CarlosVieira99/3D-Indoor-Mapping/Mechanical Structure/images/1dfa32b80d10521eedfa75d592b94568_preview_featured.jpg

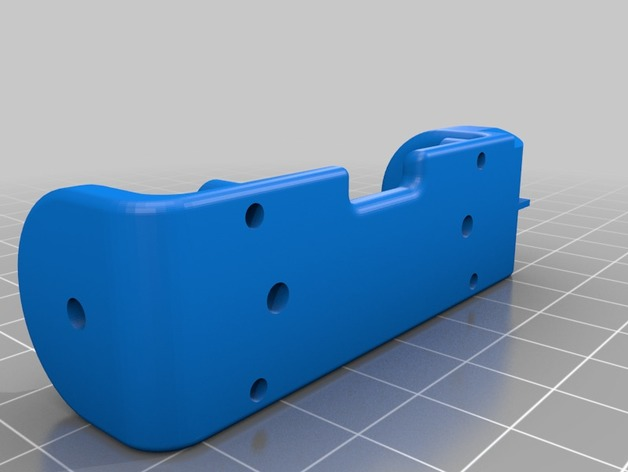
Mechanical Structure/images/1dfa32b80d10521eedfa75d592b94568_preview_featured.jpg
