CarlosVieira99/3D-Indoor-Mapping/Mechanical Structure/images/387c944284d6165e7ca117022d36e841_preview_featured.jpg

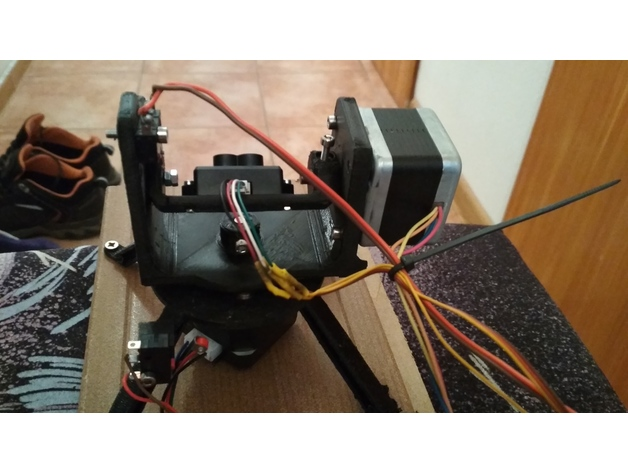
Mechanical Structure/images/387c944284d6165e7ca117022d36e841_preview_featured.jpg
