CarlosVieira99/3D-Indoor-Mapping/README.md

# 3D-Indoor-Mapping
Final year's bachelor project and report with a final classification of 19 (scale of 0 - 20). Development of a 3D Scanner for indoor spaces with applications related to architecture and civil engineering.
