CarlosVieira99/3D-Indoor-Mapping/BNO055/ACC_X.png

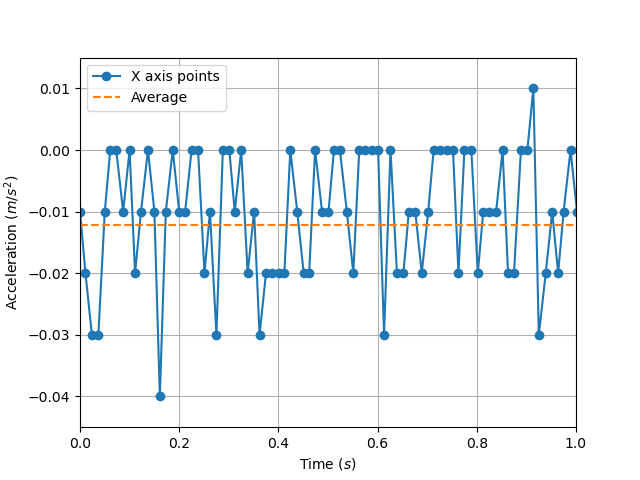
BNO055/ACC_X.png
