CarlosVieira99/3D-Indoor-Mapping/BNO055/ACC_Y.png

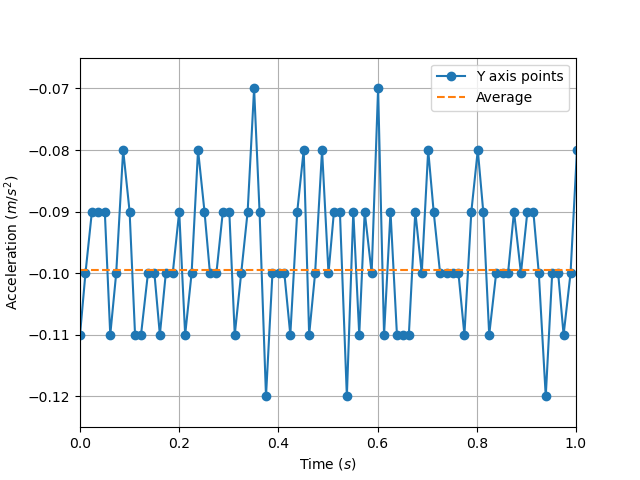
BNO055/ACC_Y.png
