CarlosVieira99/3D-Indoor-Mapping/BNO055/ACC_Z.png

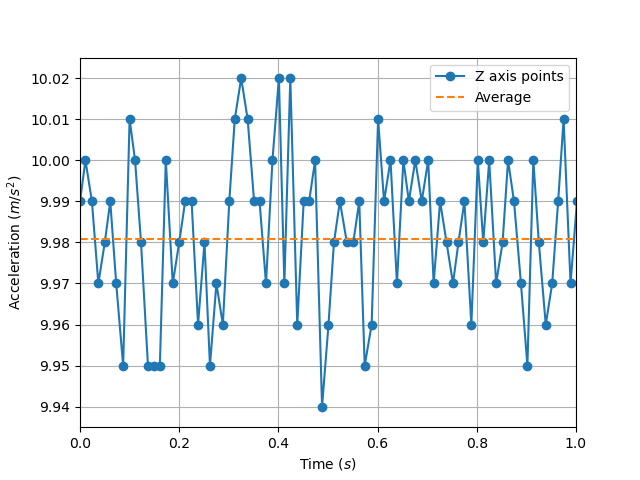
BNO055/ACC_Z.png
