CarlosVieira99/3D-Indoor-Mapping/BNO055/GYR_X.png

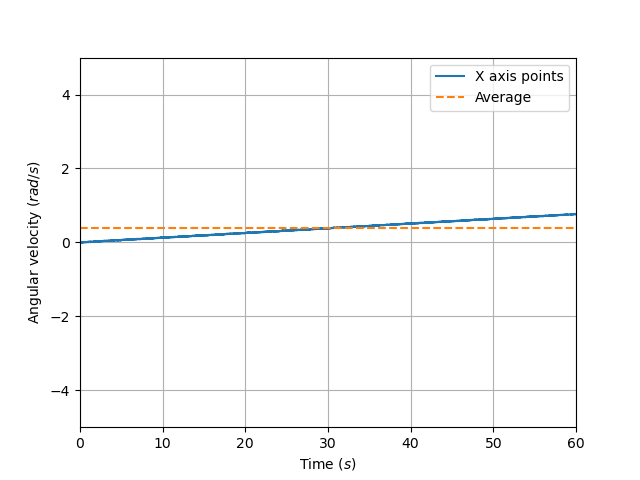
BNO055/GYR_X.png
