CarlosVieira99/3D-Indoor-Mapping/BNO055/GYR_Y.png

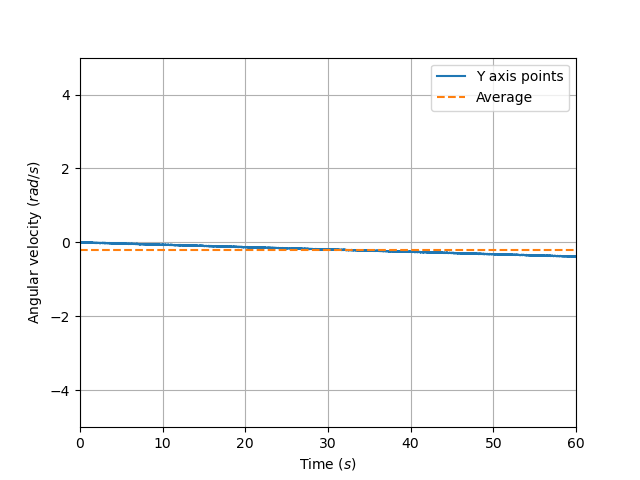
BNO055/GYR_Y.png
