CarlosVieira99/3D-Indoor-Mapping/BNO055/MAG_X.png

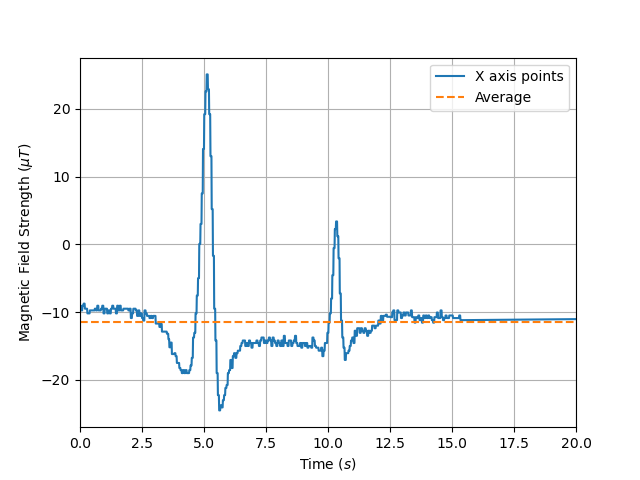
BNO055/MAG_X.png
