CarlosVieira99/3D-Indoor-Mapping/BNO055/MAG_Y.png

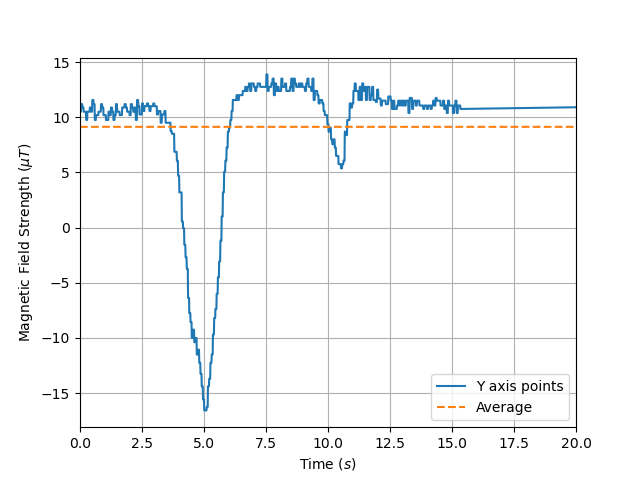
BNO055/MAG_Y.png
