CarlosVieira99/3D-Indoor-Mapping/BNO055/MAG_Z.png

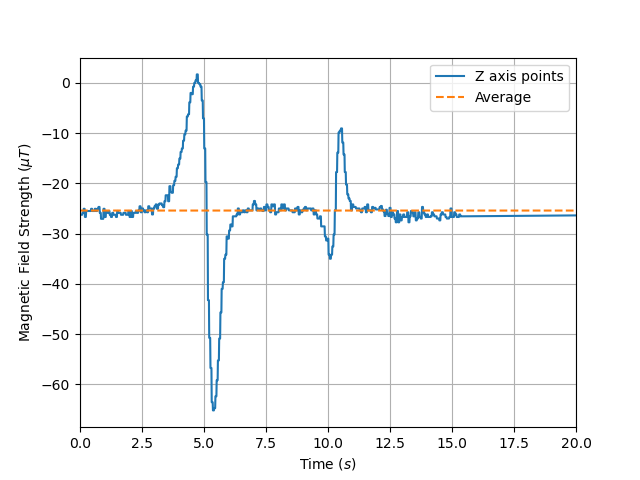
BNO055/MAG_Z.png
