CarlosVieira99/3D-Indoor-Mapping/BNO055/PITCH.png

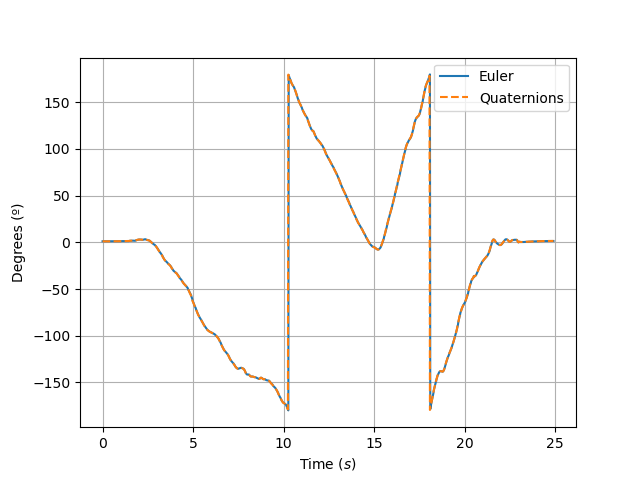
BNO055/PITCH.png
