CarlosVieira99/3D-Indoor-Mapping/BNO055/ROLL.png

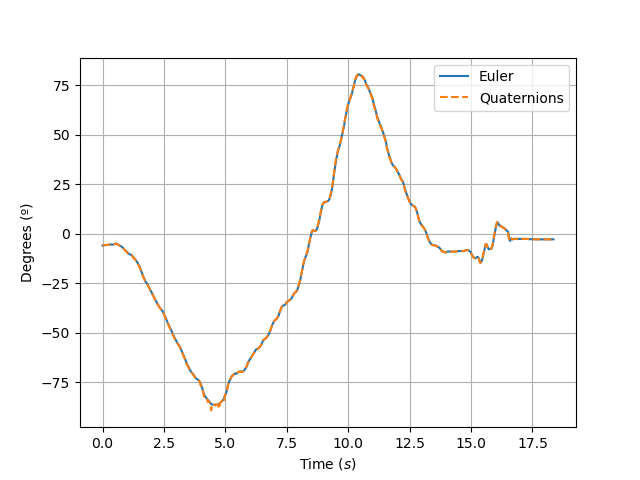
BNO055/ROLL.png
