CarlosVieira99/3D-Indoor-Mapping/BNO055/YAW.png

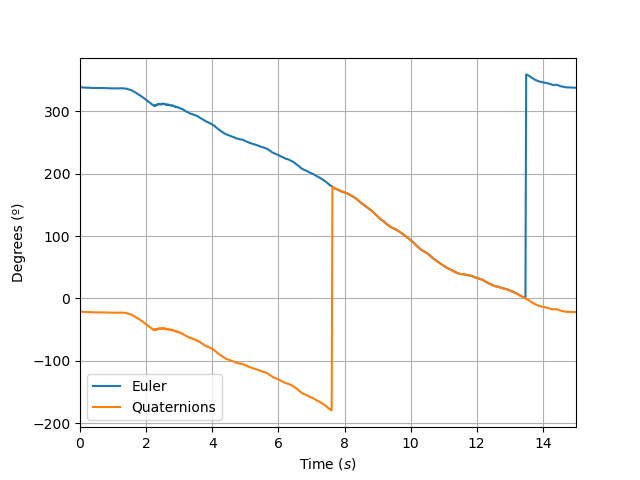
BNO055/YAW.png
