CarlosVieira99/3D-Indoor-Mapping/Mechanical Structure/case_pcb.png

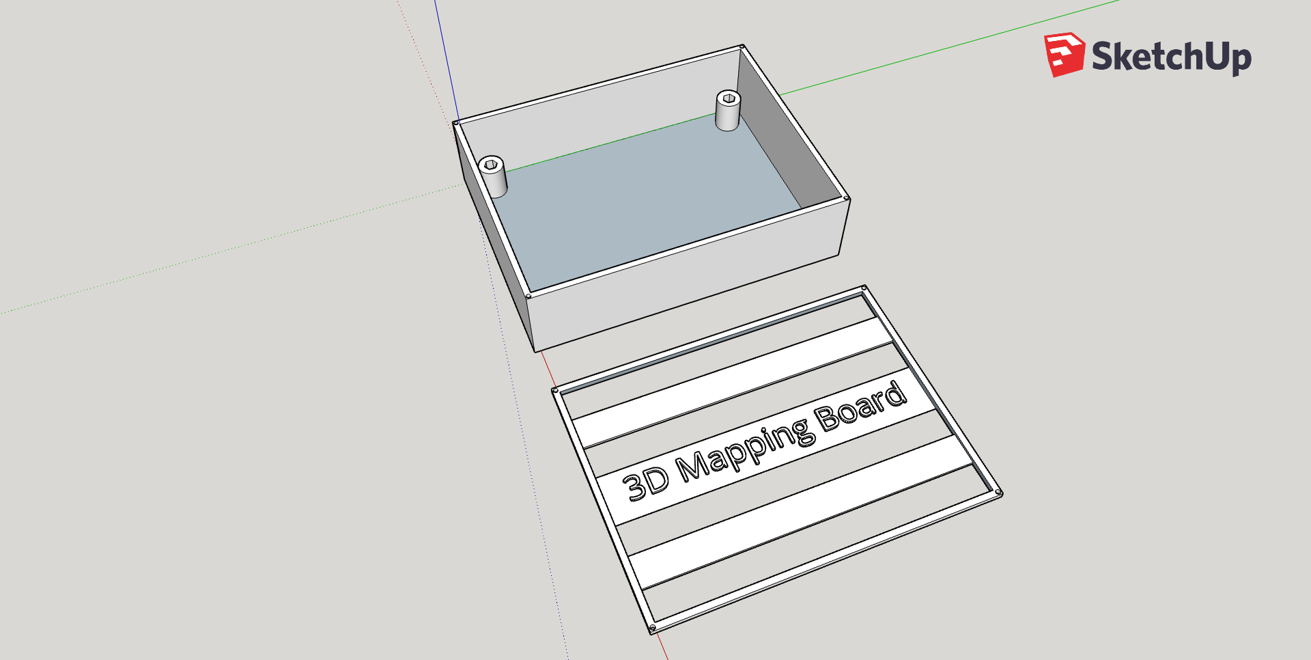
Mechanical Structure/case_pcb.png
