CarlosVieira99/3D-Indoor-Mapping/Mechanical Structure/images/2bb4d0dabb0714f8ff6427e0e310aa0e_preview_featured.jpg

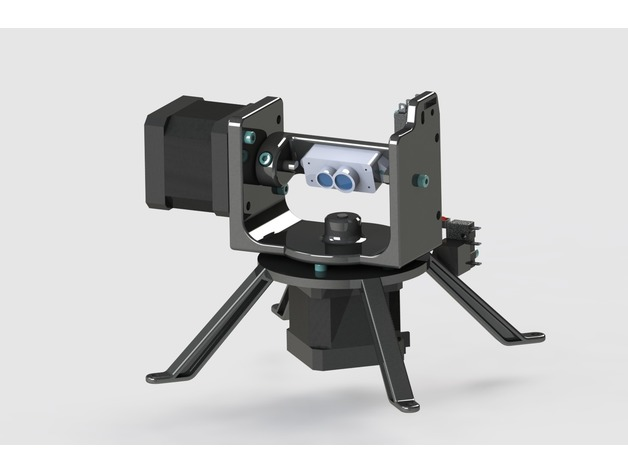
Mechanical Structure/images/2bb4d0dabb0714f8ff6427e0e310aa0e_preview_featured.jpg
