CarlosVieira99/3D-Indoor-Mapping/Mechanical Structure/images/4da6ced4066a0352c191759d1605e79c_preview_featured.jpg

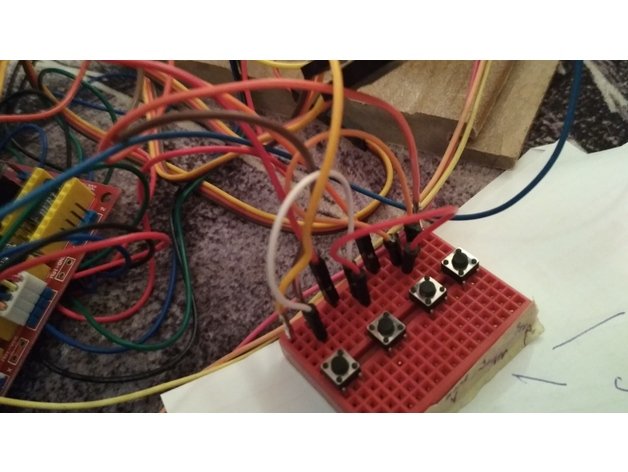
Mechanical Structure/images/4da6ced4066a0352c191759d1605e79c_preview_featured.jpg
