CarlosVieira99/3D-Indoor-Mapping/Mechanical Structure/images/55c08e975283f3232b39a6d8d862f61d_preview_featured.jpg

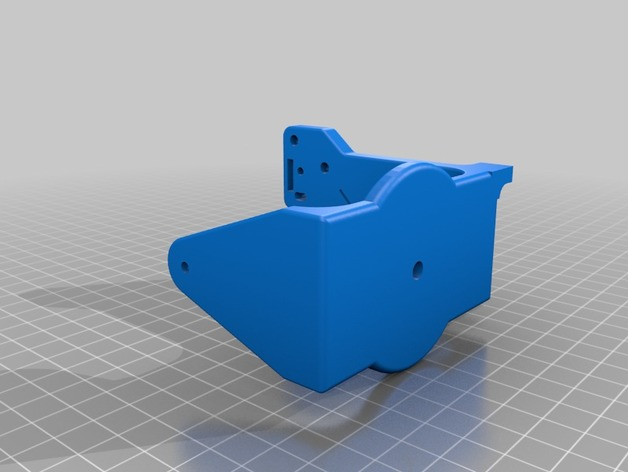
Mechanical Structure/images/55c08e975283f3232b39a6d8d862f61d_preview_featured.jpg
