CarlosVieira99/3D-Indoor-Mapping/Mechanical Structure/images/73e55405f893b6189121a46dec58b1c0_preview_featured.jpg

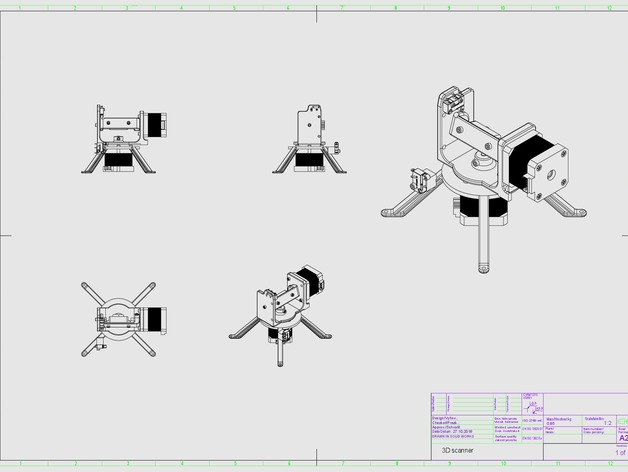
Mechanical Structure/images/73e55405f893b6189121a46dec58b1c0_preview_featured.jpg
