CarlosVieira99/3D-Indoor-Mapping/Mechanical Structure/images/177eeb8ad4d8bed2c6603e06b150ce1c_preview_featured.jpg

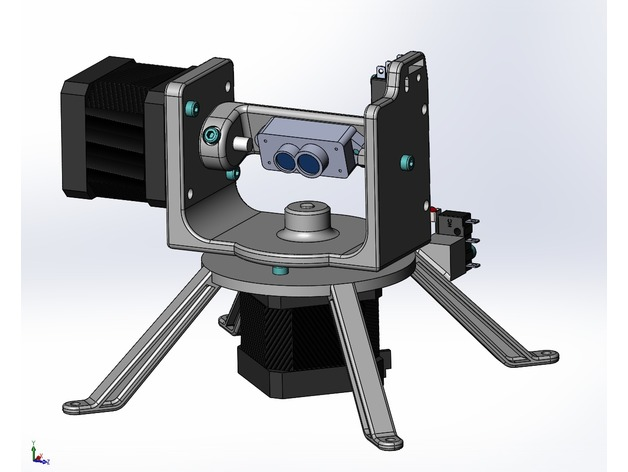
Mechanical Structure/images/177eeb8ad4d8bed2c6603e06b150ce1c_preview_featured.jpg
