CarlosVieira99/3D-Indoor-Mapping/Mechanical Structure/images/0367f8c9bfd212b43cd1ec062f2c5a4a_preview_featured.jpg

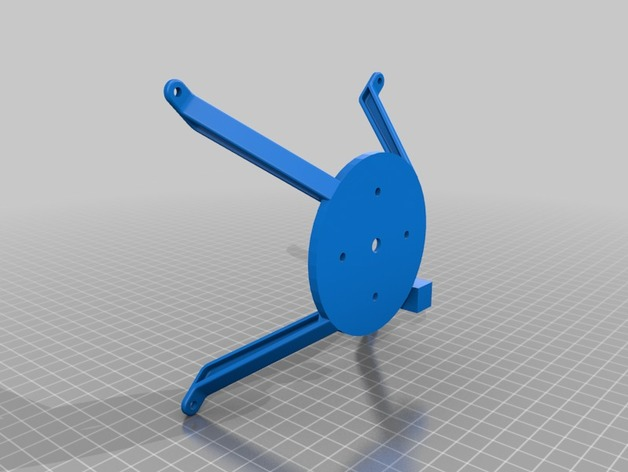
Mechanical Structure/images/0367f8c9bfd212b43cd1ec062f2c5a4a_preview_featured.jpg
