CarlosVieira99/3D-Indoor-Mapping/Mechanical Structure/images/50722d846d7203ce73d94f9868e5be8e_preview_featured.JPG

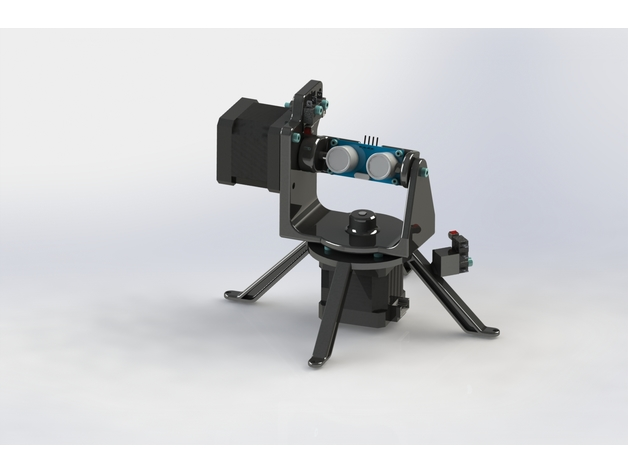
Mechanical Structure/images/50722d846d7203ce73d94f9868e5be8e_preview_featured.JPG
