CarlosVieira99/3D-Indoor-Mapping/Mechanical Structure/images/b529cb4edfc250e49e4f99960e645187_preview_featured.jpg

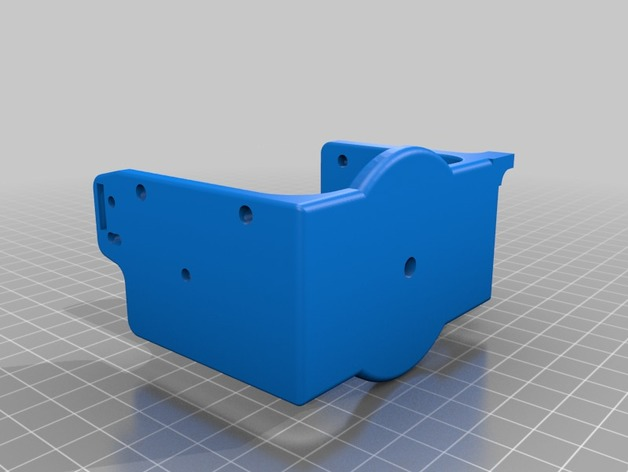
Mechanical Structure/images/b529cb4edfc250e49e4f99960e645187_preview_featured.jpg
