CarlosVieira99/3D-Indoor-Mapping/Mechanical Structure/images/b7080d9011f67d9f4980e71822f7f7c1_preview_featured.jpg

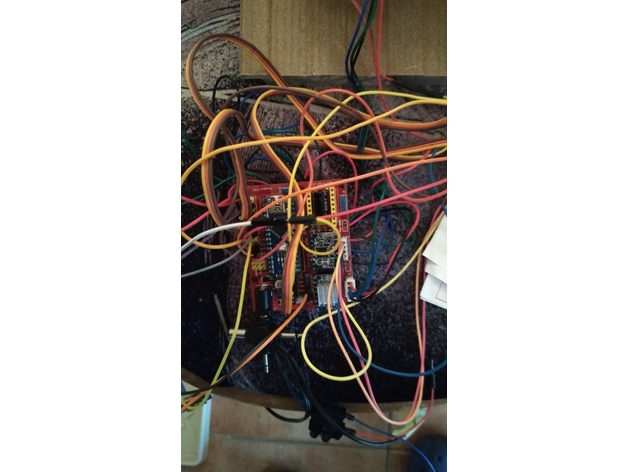
Mechanical Structure/images/b7080d9011f67d9f4980e71822f7f7c1_preview_featured.jpg
