CarlosVieira99/3D-Indoor-Mapping/Mechanical Structure/images/eead3b37182fbacccb547434da534182_preview_featured.jpg

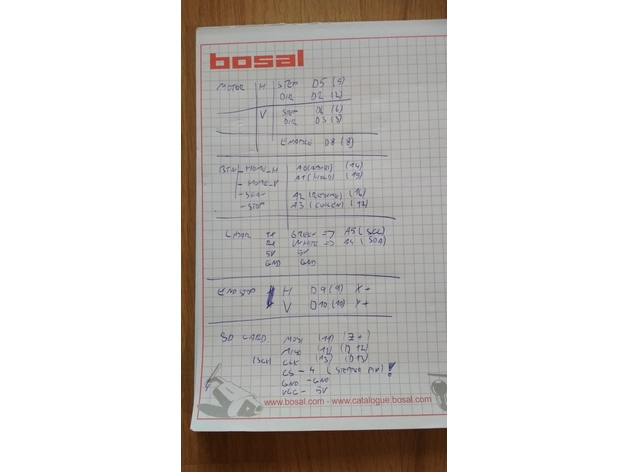
Mechanical Structure/images/eead3b37182fbacccb547434da534182_preview_featured.jpg
