CarlosVieira99/3D-Indoor-Mapping/PCB and Base Design/acricilico v2.png

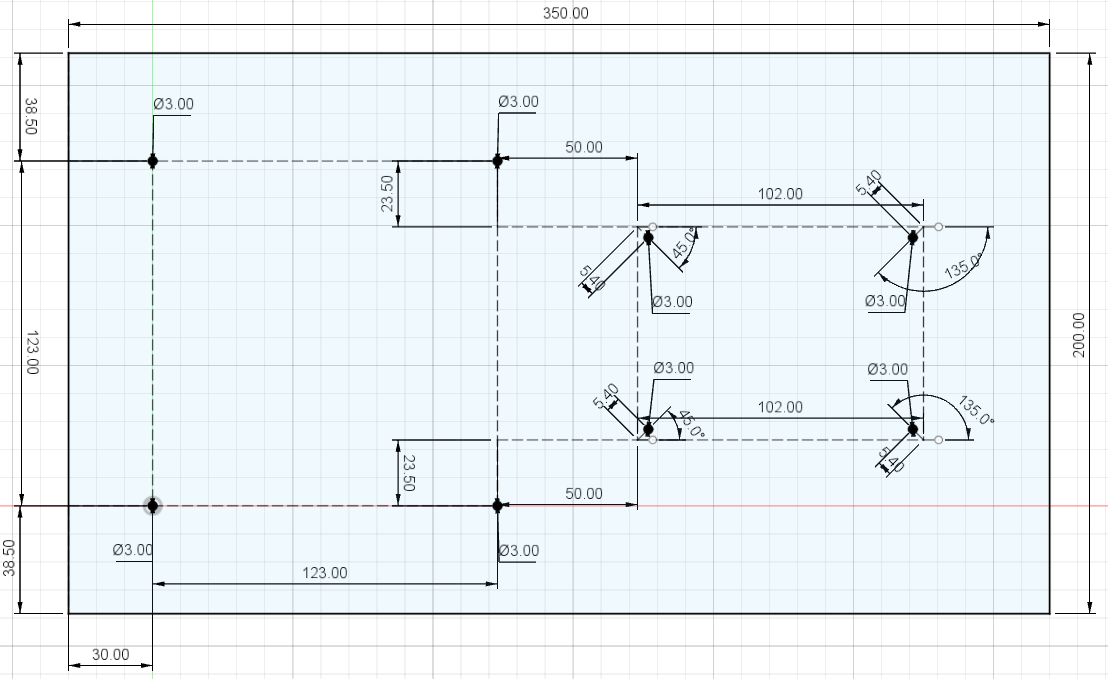
PCB and Base Design/acricilico v2.png
