CarlosVieira99/3D-Indoor-Mapping/User Interface/img/DEE.jpg

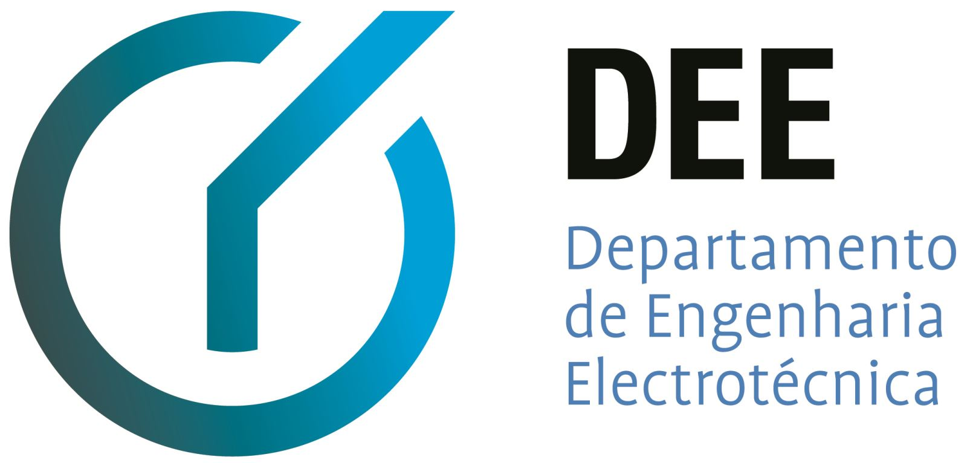
User Interface/img/DEE.jpg
