CarlosVieira99/3D-Indoor-Mapping/User Interface/img/isep.jpeg

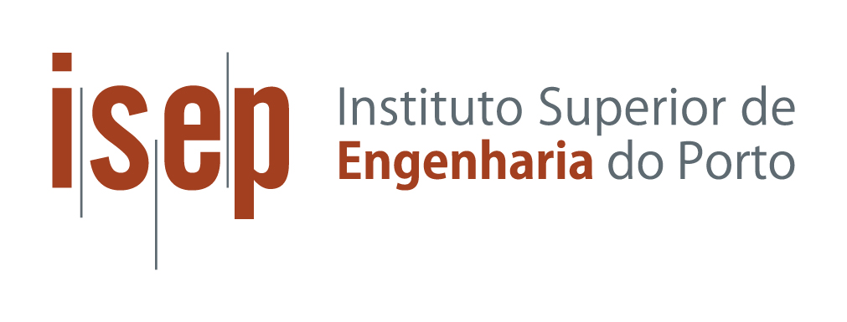
User Interface/img/isep.jpeg
