CarlosVieira99/3D-Indoor-Mapping/Mechanical Structure/files/console2v2.STL

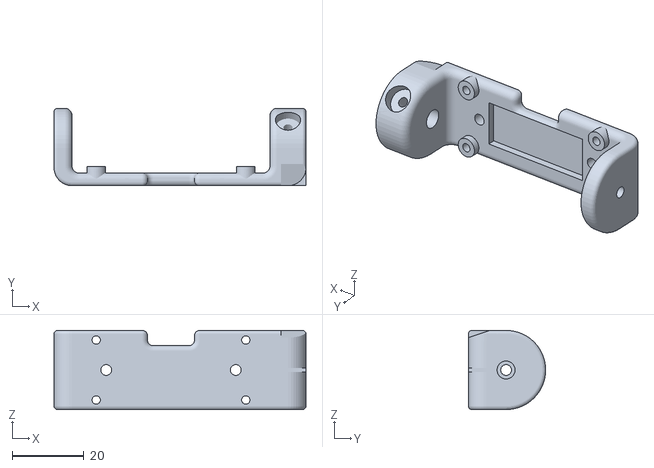
[picture p120: CAD file, 2021-06-29]
Mechanical Structure/files/console2v2.STL
70.0 x 21.5 x 22.0
