CarlosVieira99/3D-Indoor-Mapping/Mechanical Structure/files/console2.STL

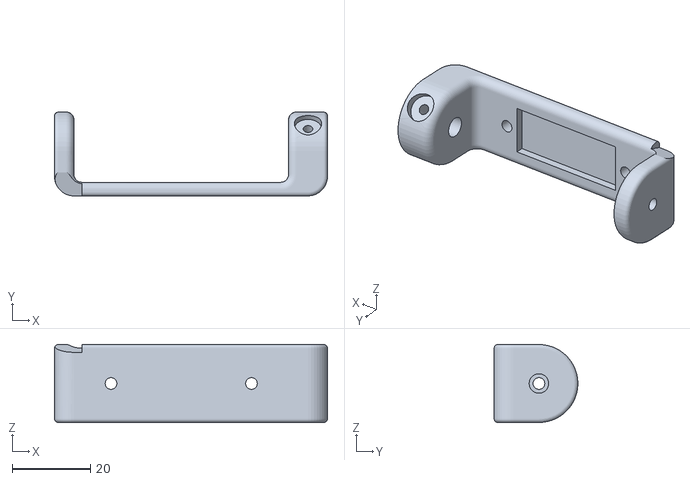
[picture p121: CAD file, 2021-06-29]
Mechanical Structure/files/console2.STL
70.0 x 21.5 x 20.0
