CarlosVieira99/3D-Indoor-Mapping/Mechanical Structure/files/Console1.STL

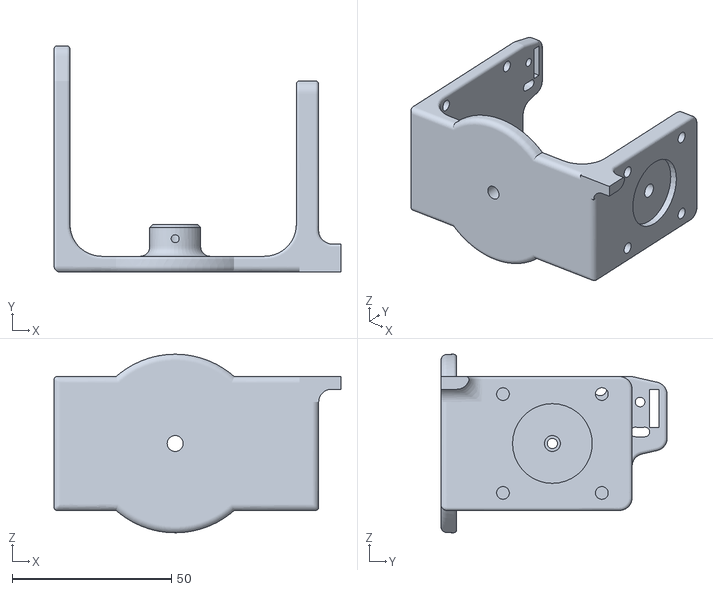
[picture p122: CAD file, 2021-06-29]
Mechanical Structure/files/Console1.STL
90.0 x 71.0 x 56.0
