CarlosVieira99/3D-Indoor-Mapping/Mechanical Structure/files/stand.STL

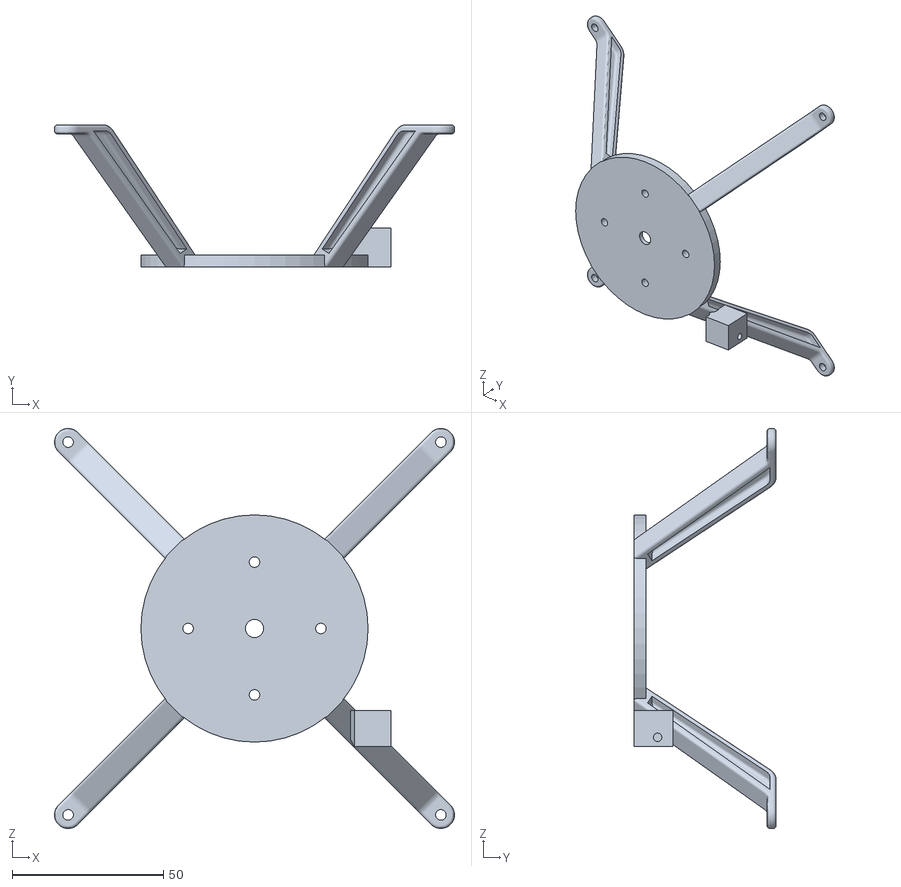
[picture p123: CAD file, 2021-06-29]
Mechanical Structure/files/stand.STL
132.0 x 47.0 x 132.0
