CarlosVieira99/3D-Indoor-Mapping/Mechanical Structure/files/Console1v2.STL

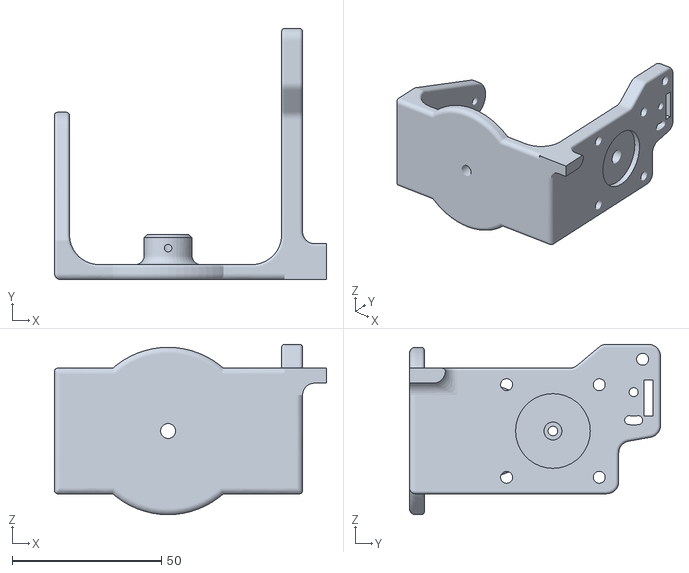
[picture p124: CAD file, 2021-06-29]
Mechanical Structure/files/Console1v2.STL
91.0 x 84.0 x 57.0
