CarlosVieira99/3D-Indoor-Mapping/(list of files, cad)

Other CAD files:
Point Clouds Results/Full Step Mode/FullAutoCadPoints.dwg
PCB and Base Design/acricilico v2.dwg
Point Clouds Results/Half Step Mode/xyz_file.dxf
Point Clouds Results/Quarter Step Mode/xyz_file.dxf
