CarlosVieira99/3D-Indoor-Mapping/Point Clouds Results/Full Step Mode/BluePrintFull.png

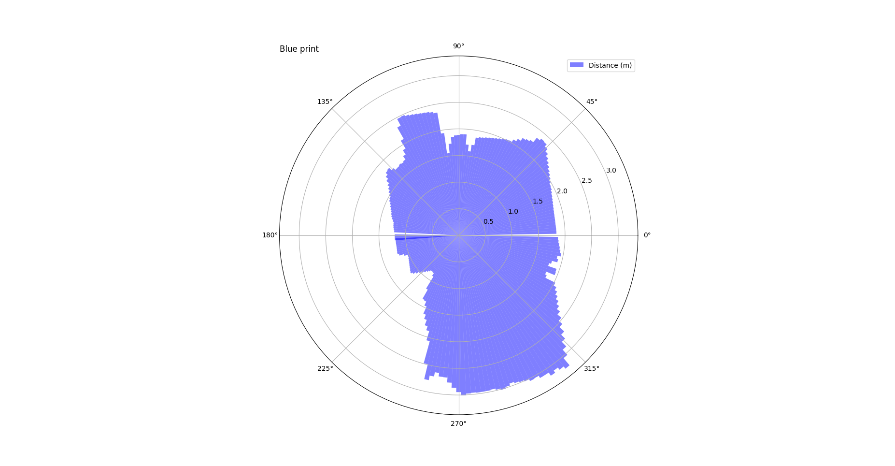
Point Clouds Results/Full Step Mode/BluePrintFull.png
