CarlosVieira99/3D-Indoor-Mapping/Point Clouds Results/Full Step Mode/Figure_1.png

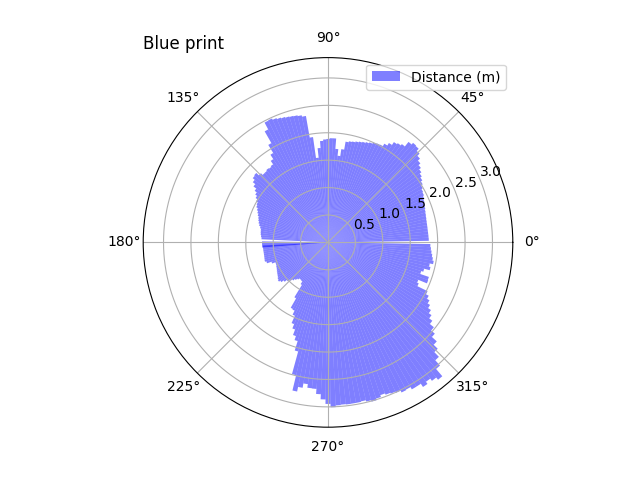
Point Clouds Results/Full Step Mode/Figure_1.png
