CarlosVieira99/3D-Indoor-Mapping/Point Clouds Results/Full Step Mode/FullBlack.png

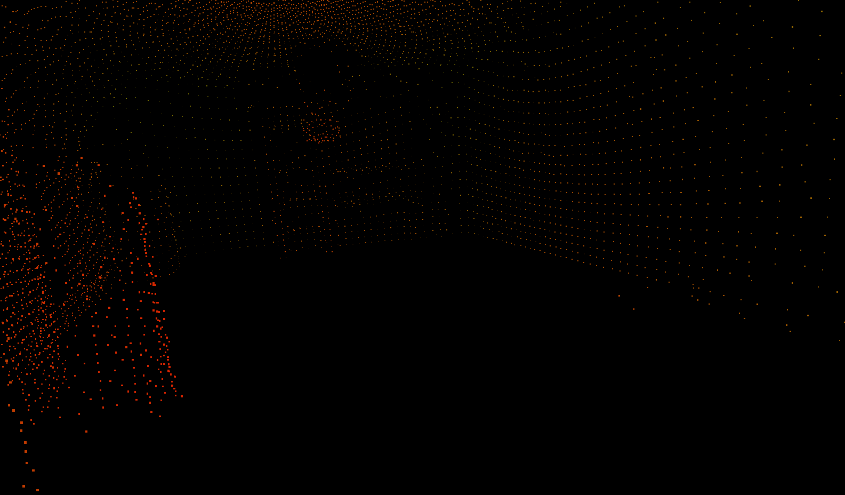
Point Clouds Results/Full Step Mode/FullBlack.png
