CarlosVieira99/3D-Indoor-Mapping/Point Clouds Results/Full Step Mode/FullBlackOut.png

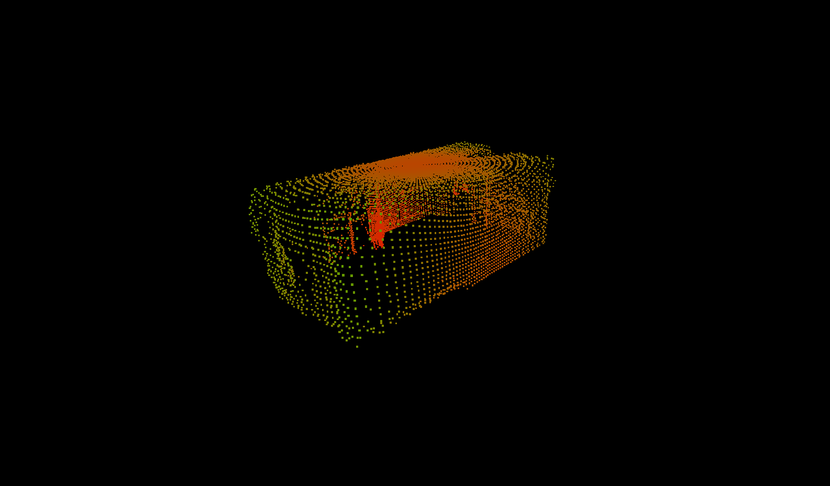
Point Clouds Results/Full Step Mode/FullBlackOut.png
