CarlosVieira99/3D-Indoor-Mapping/Point Clouds Results/Full Step Mode/FullBlackTop.png

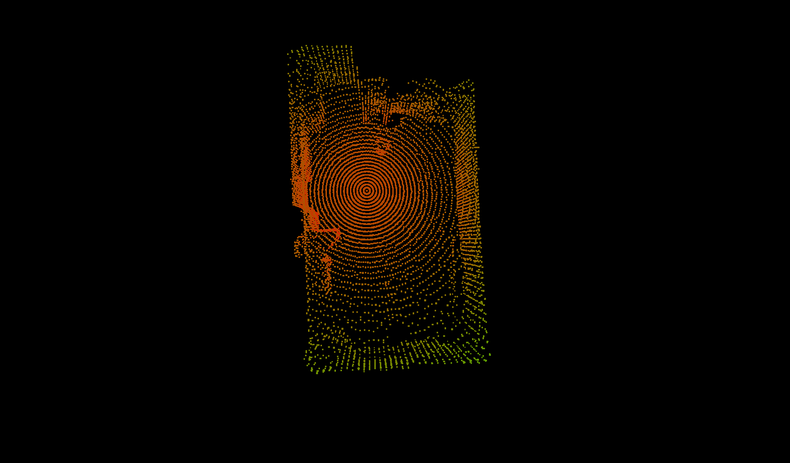
Point Clouds Results/Full Step Mode/FullBlackTop.png
