CarlosVieira99/3D-Indoor-Mapping/Point Clouds Results/Full Step Mode/FullWhite.png

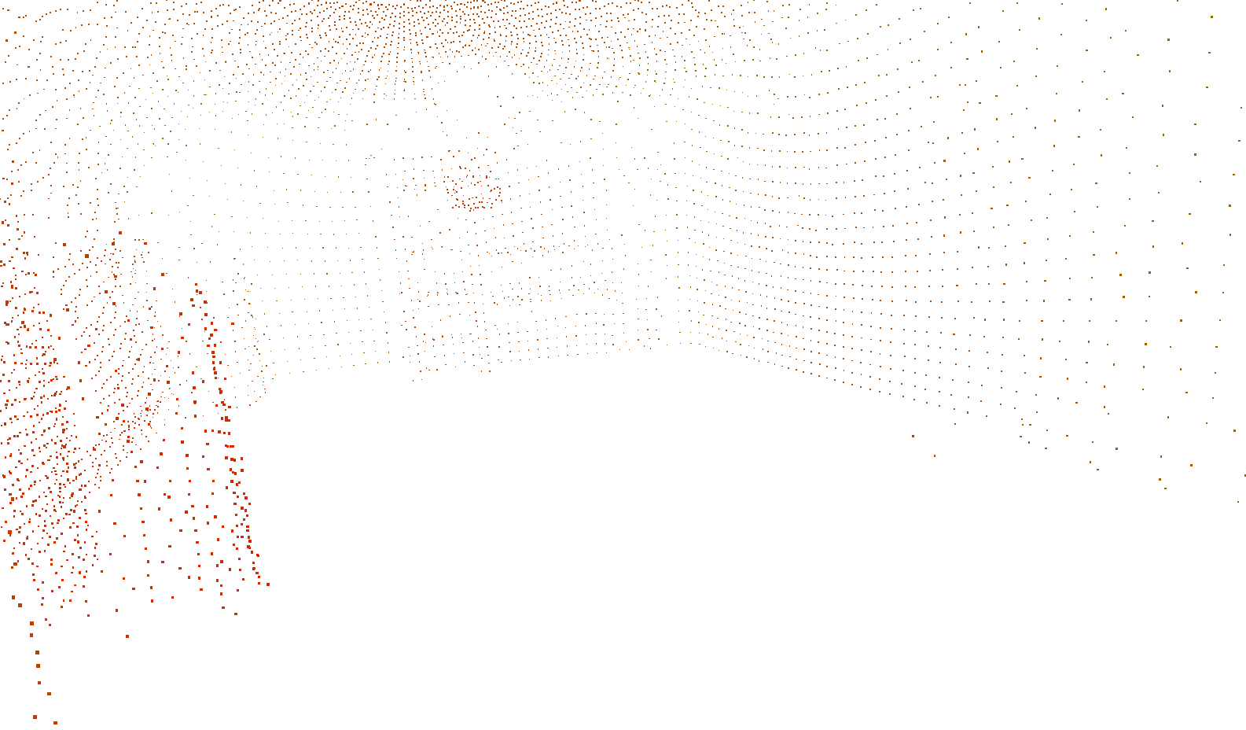
Point Clouds Results/Full Step Mode/FullWhite.png
