CarlosVieira99/3D-Indoor-Mapping/Point Clouds Results/Full Step Mode/FullWhiteOut.png

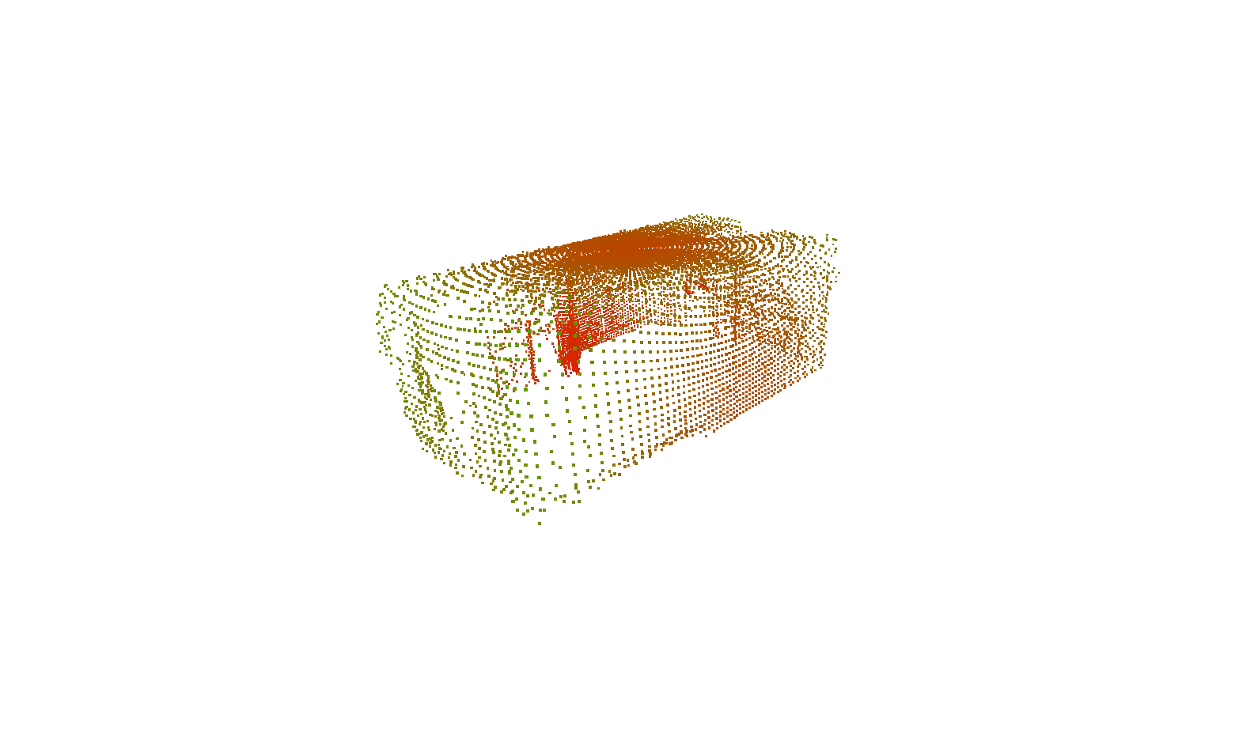
Point Clouds Results/Full Step Mode/FullWhiteOut.png
