CarlosVieira99/3D-Indoor-Mapping/Point Clouds Results/Full Step Mode/FullWhiteTop.png

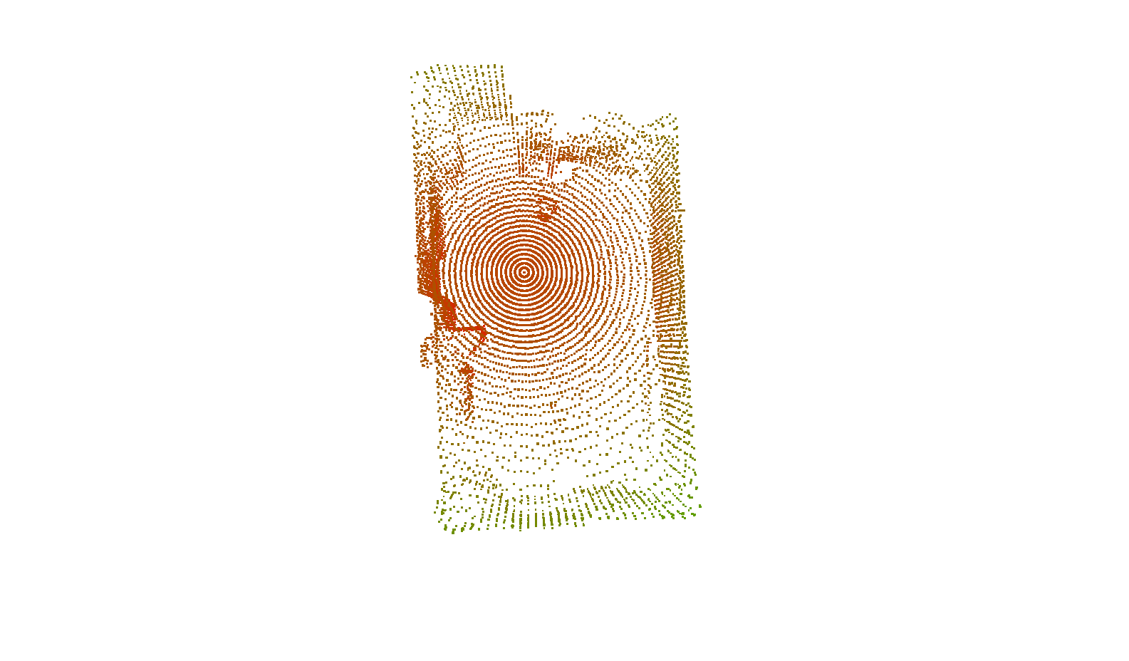
Point Clouds Results/Full Step Mode/FullWhiteTop.png
