CarlosVieira99/3D-Indoor-Mapping/Point Clouds Results/Half Step Mode/HalfWhite.png

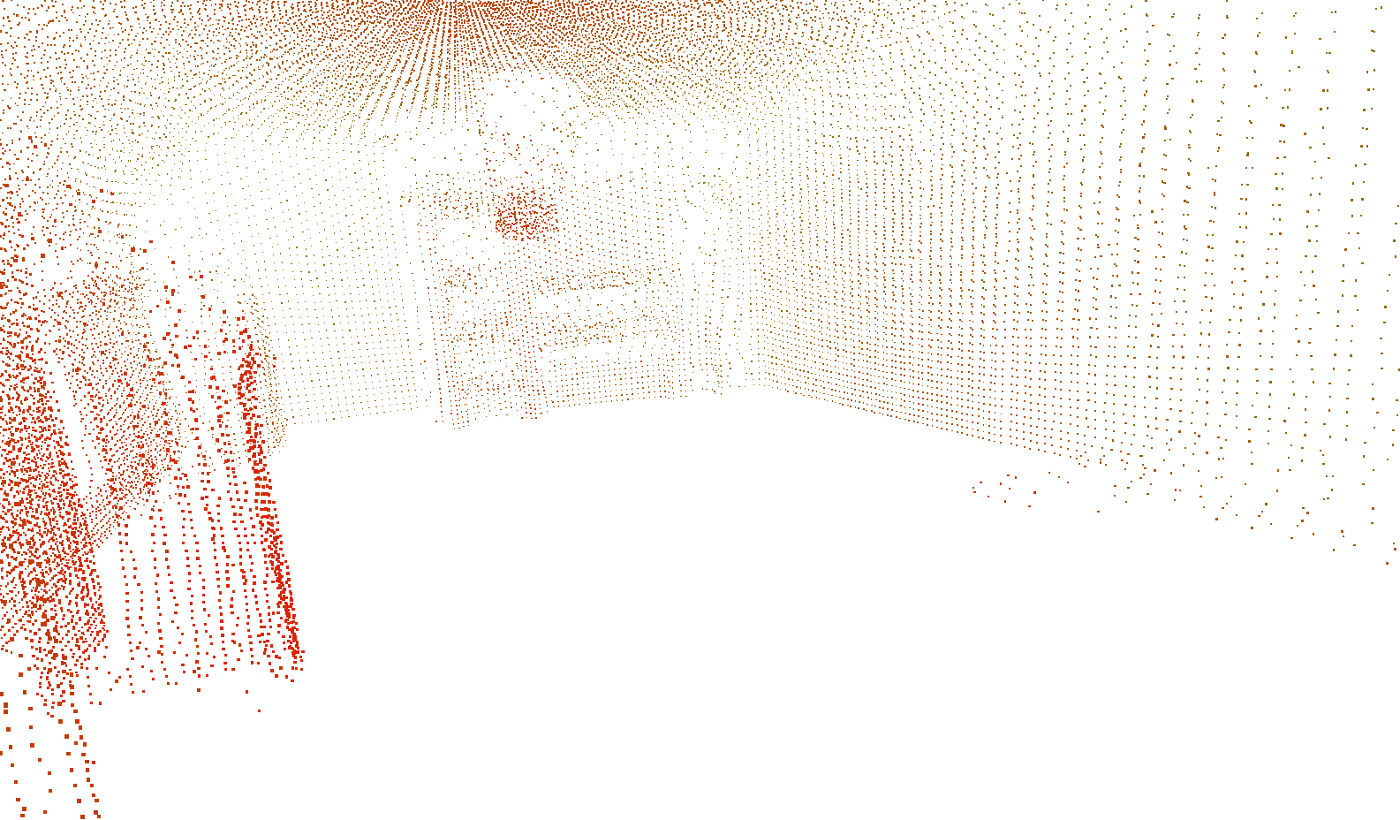
Point Clouds Results/Half Step Mode/HalfWhite.png
