CarlosVieira99/3D-Indoor-Mapping/Point Clouds Results/Half Step Mode/screenshot2.png

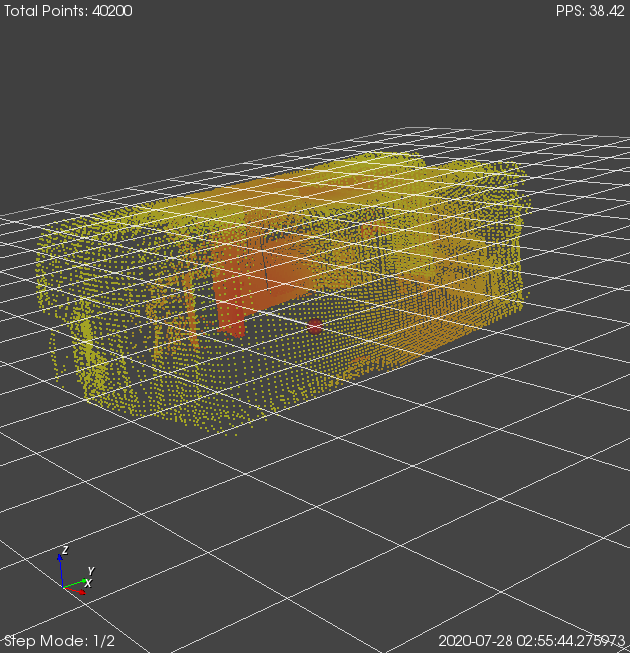
Point Clouds Results/Half Step Mode/screenshot2.png
