CarlosVieira99/3D-Indoor-Mapping/Point Clouds Results/Quarter Step Mode/QuarterBlack.png

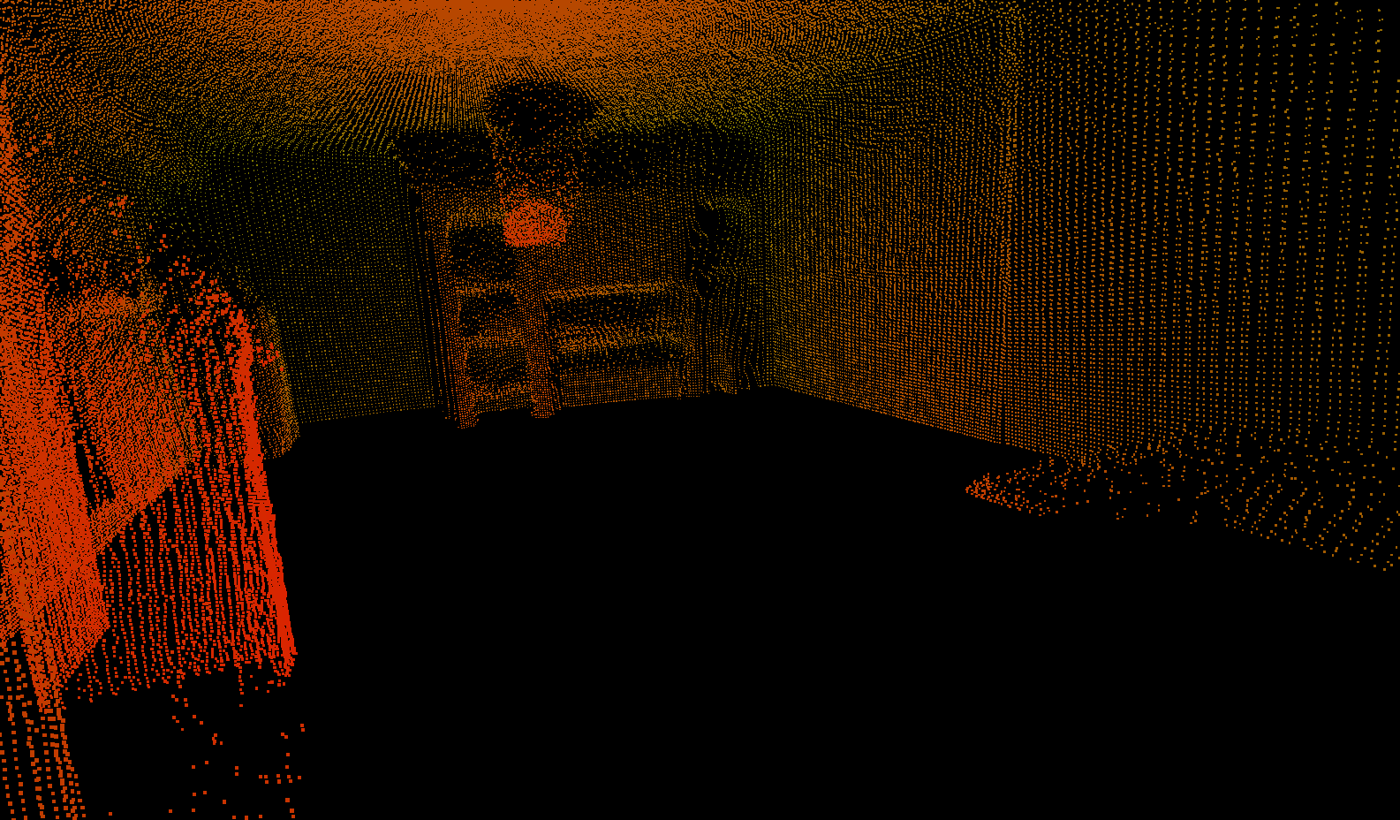
Point Clouds Results/Quarter Step Mode/QuarterBlack.png
