CarlosVieira99/3D-Indoor-Mapping/Point Clouds Results/Quarter Step Mode/QuarterWhite.png

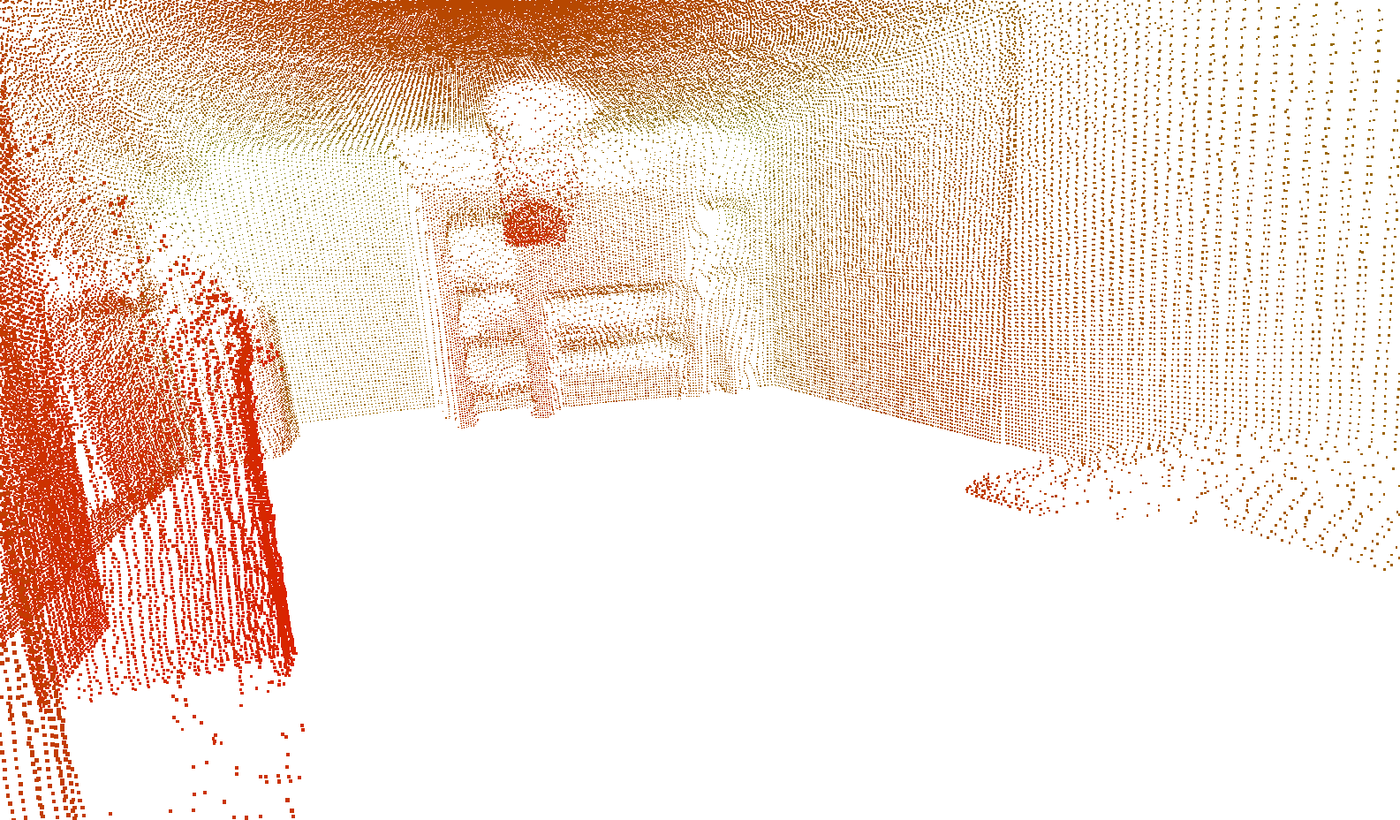
Point Clouds Results/Quarter Step Mode/QuarterWhite.png
