CarlosVieira99/3D-Indoor-Mapping/Point Clouds Results/Quarter Step Mode/QuarterWhiteOut.png

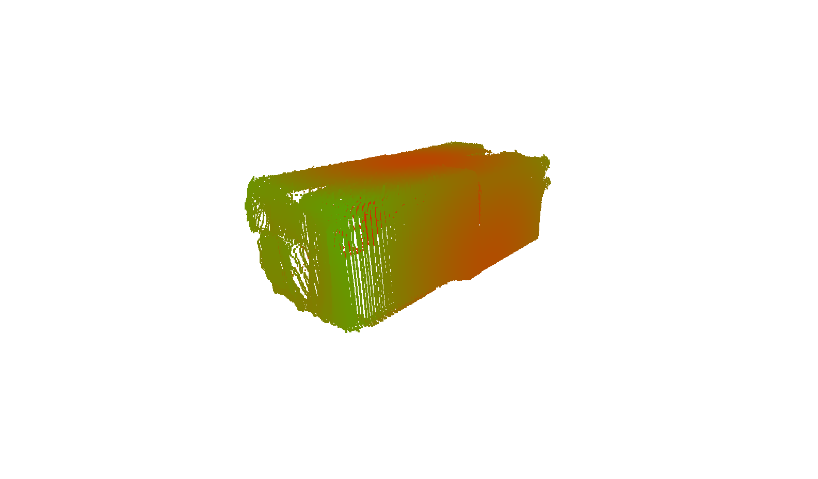
Point Clouds Results/Quarter Step Mode/QuarterWhiteOut.png
