CarlosVieira99/3D-Indoor-Mapping/Point Clouds Results/Quarter Step Mode/screenshot4.png

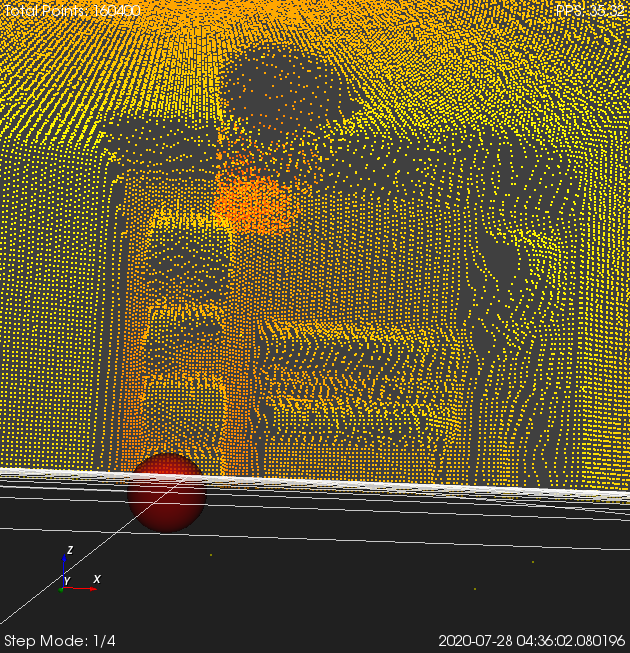
Point Clouds Results/Quarter Step Mode/screenshot4.png
