CarlosVieira99/3D-Indoor-Mapping/TFmini-S/Test1_error.png

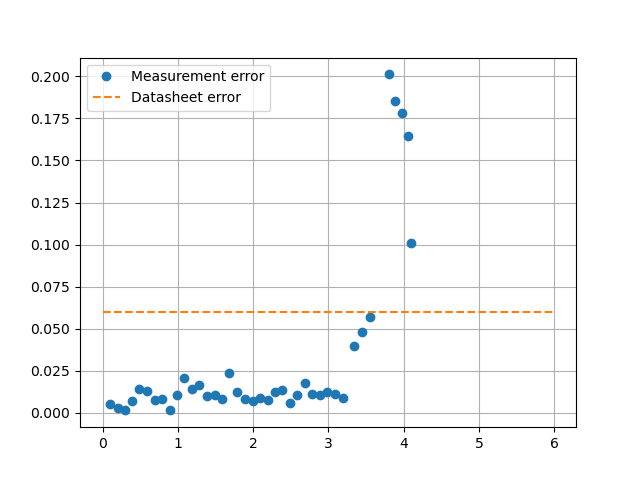
TFmini-S/Test1_error.png
