CarlosVieira99/3D-Indoor-Mapping/TFmini-S/Test2_error.png

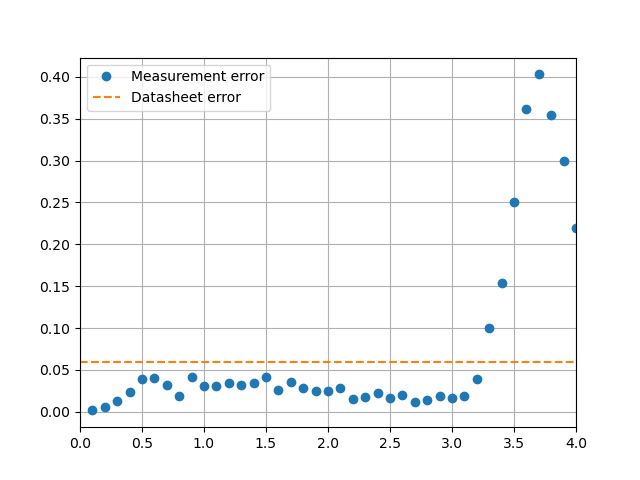
TFmini-S/Test2_error.png
