CarlosVieira99/3D-Indoor-Mapping/TFmini-S/Test3_error.png

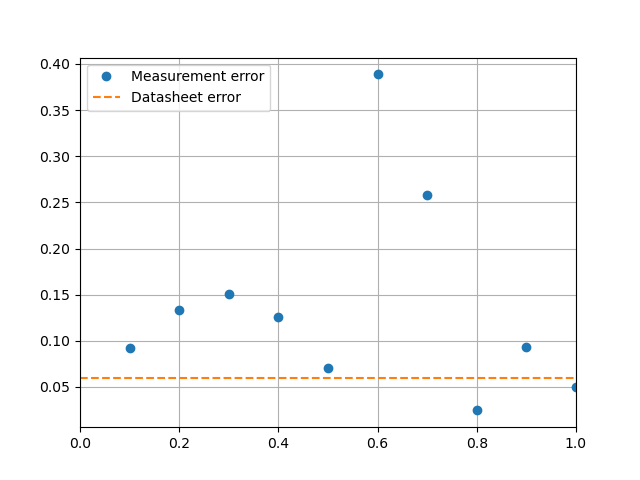
TFmini-S/Test3_error.png
