CarlosVieira99/3D-Indoor-Mapping/TFmini-S/Teste1_dist.png

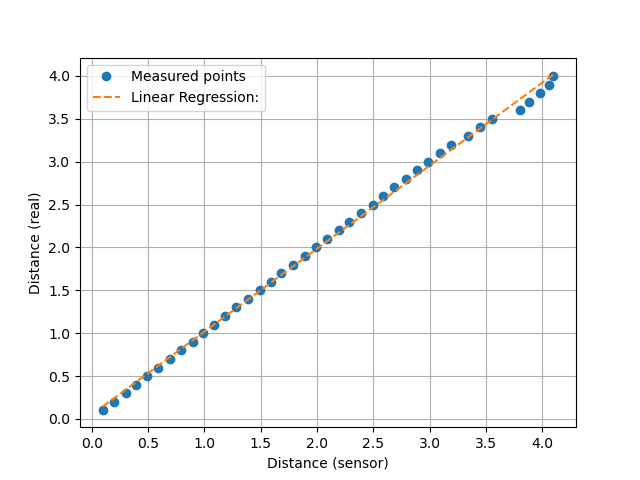
TFmini-S/Teste1_dist.png
