CarlosVieira99/3D-Indoor-Mapping/TFmini-S/Teste2_dist.png

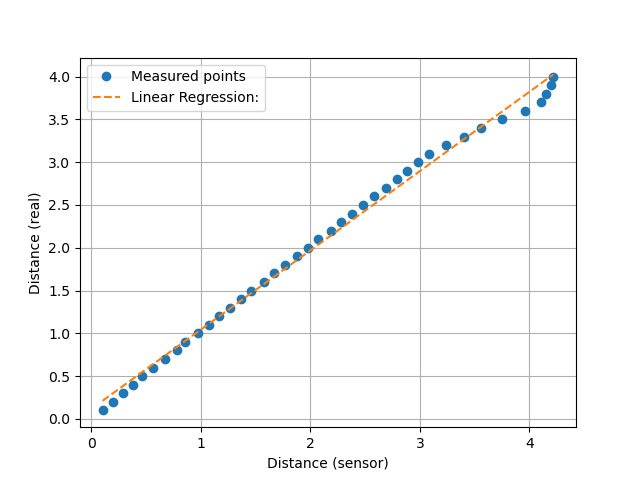
TFmini-S/Teste2_dist.png
