CarlosVieira99/3D-Indoor-Mapping/TFmini-S/Teste3_dist.png

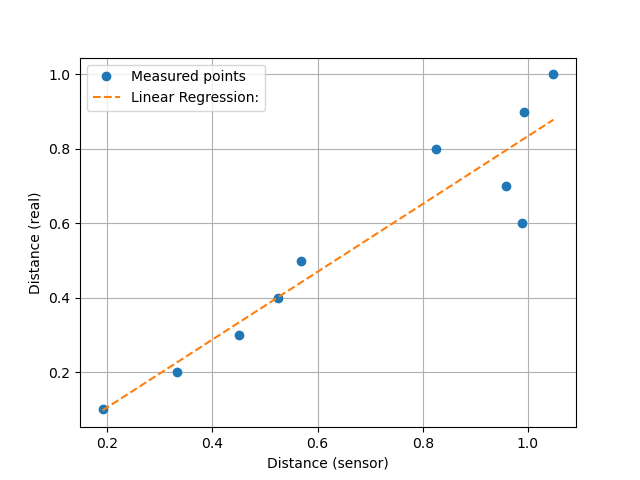
TFmini-S/Teste3_dist.png
