CarlosVieira99/3D-Indoor-Mapping/Architecture.pdf

# 3D Indoor Mapping

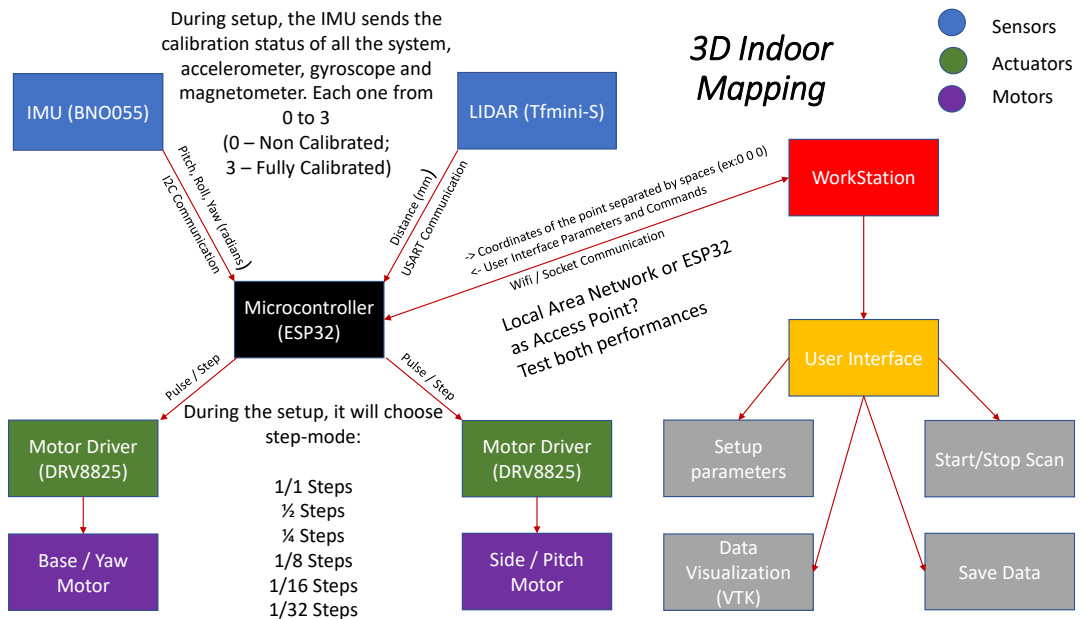
[picture p147: page 1]
Microcontroller (ESP32); Side / Pitch Motor; Base / Yaw Motor; Motor Driver (DRV8825); IMU (BNO055); LIDAR (Tfmini-S); WorkStation; Sensors; Actuators; Motors; User Interface; Setup parameters; Save Data; Data Visualization (VTK); 0 to 3 (0 – Non Calibrated; 3 – Fully Calibrated); step-mode:; 1/1 Steps ½ Steps ¼ Steps 1/8 Steps 1/16 Steps 1/32 Steps

During setup, the IMU sends the
calibration status of all the system,
accelerometer, gyroscope and
magnetometer. Each one from

During the setup, it will choose

Start/Stop Scan

IMU (BNO055)

All sensors available outputs

LIDAR (Tfmini-S)

- Calibration Status (0 to 3)
- Accelerometer (m/s)
- Gyrsoscope (deg/s or rad/s)
- Magnetometer (uTesla)
- Euler Angles (degrees or radians)
- Quaternions (unit quaternion)
- Linear Acceleration (m/s)
- Gravity Vector (m/s^2)
- Temperature (Celsius or Fahrenheit)
- Distance (cm or mm)
- Strength of the signal (0-65535)
- Temperature (Celsius or Fahrenheit)
