CarlosVieira99/3D-Indoor-Mapping/Mechanical Structure/files/3D_scanner.PDF

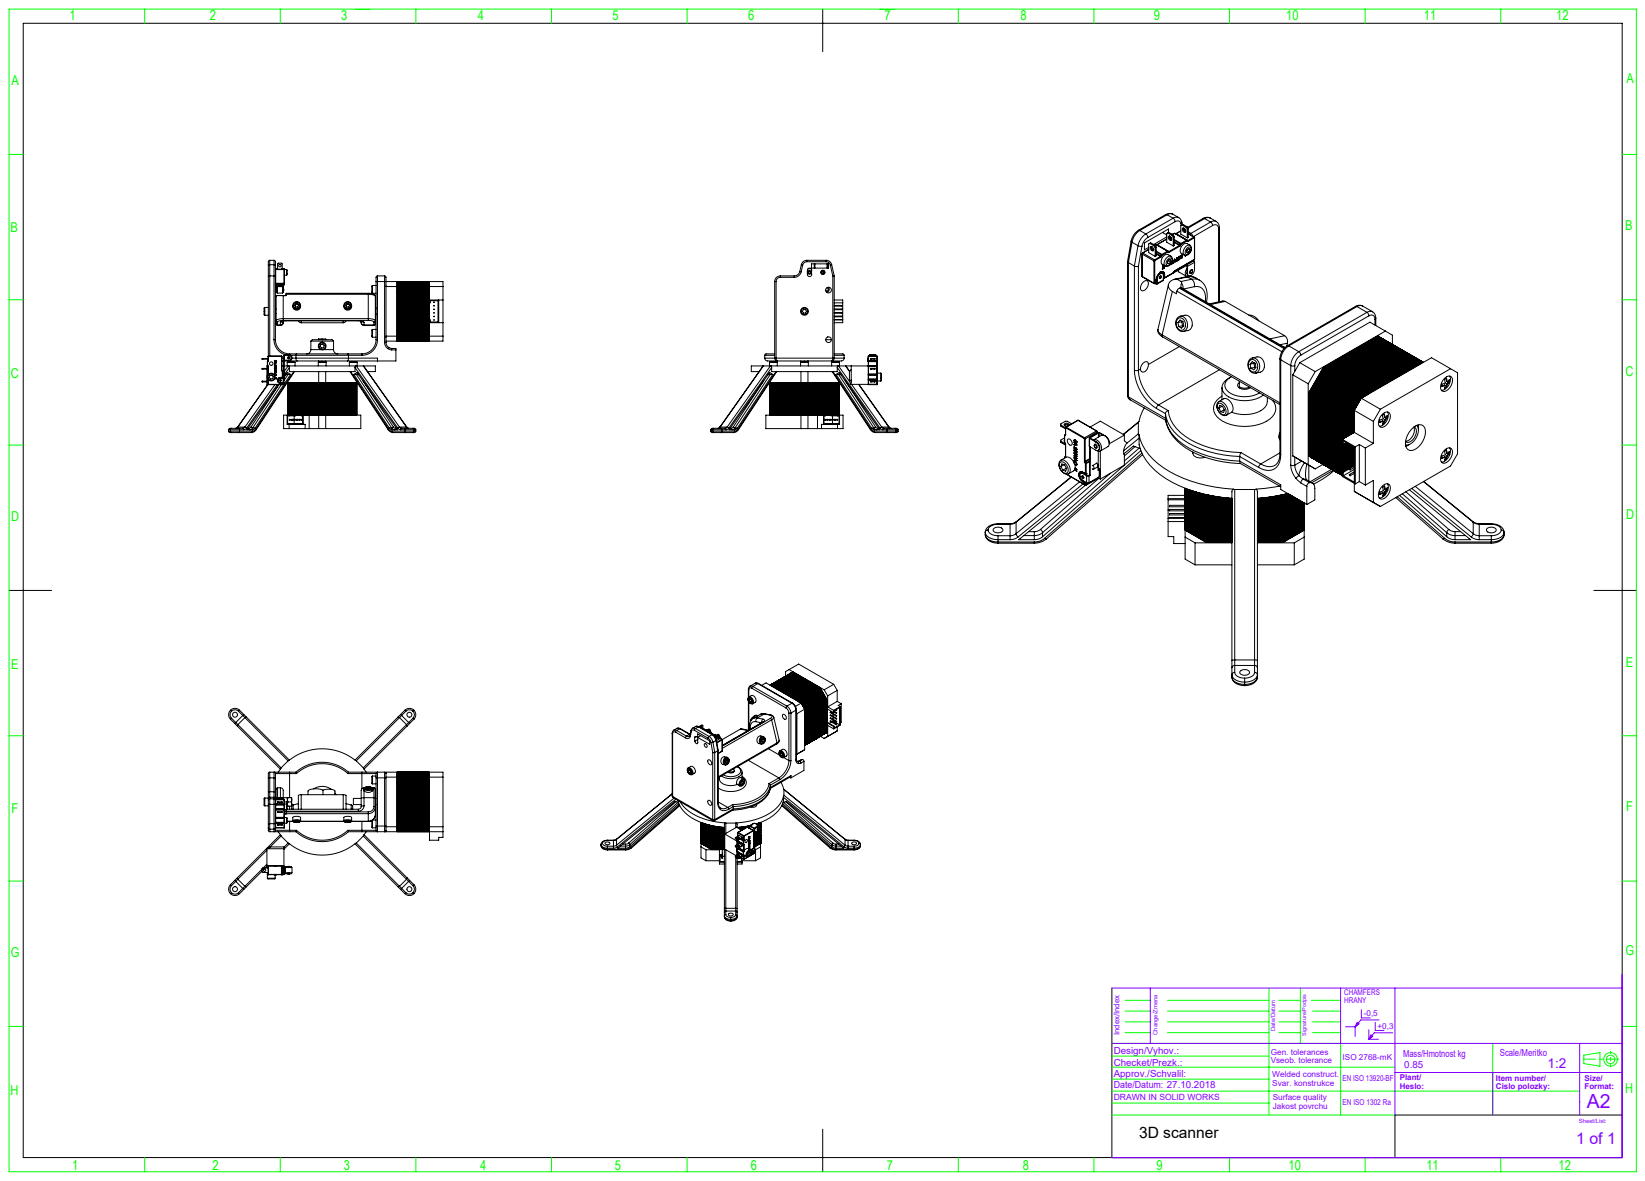
[picture p148: page 1]
Mass/Hmotnost kg; Item number/ Cislo polozky:; Jakost povrchu; EN ISO 1302 Ra

Design/Vyhov.:
Checket/Prezk.:
Approv./Schvalil:
Date/Datum:
DRAWN IN SOLID WORKS
3D scanner

Gen. tolerances
Vseob. tolerance ISO 2768-mK
Welded construct.
Svar. konstrukce
Surface quality

EN ISO 13920-BF
