CarlosVieira99/3D-Indoor-Mapping/PCB and Base Design/placa_modular.kicad_pcb

## KiCad design PCB and Base Design/placa_modular.kicad_pcb (2021-06-29)

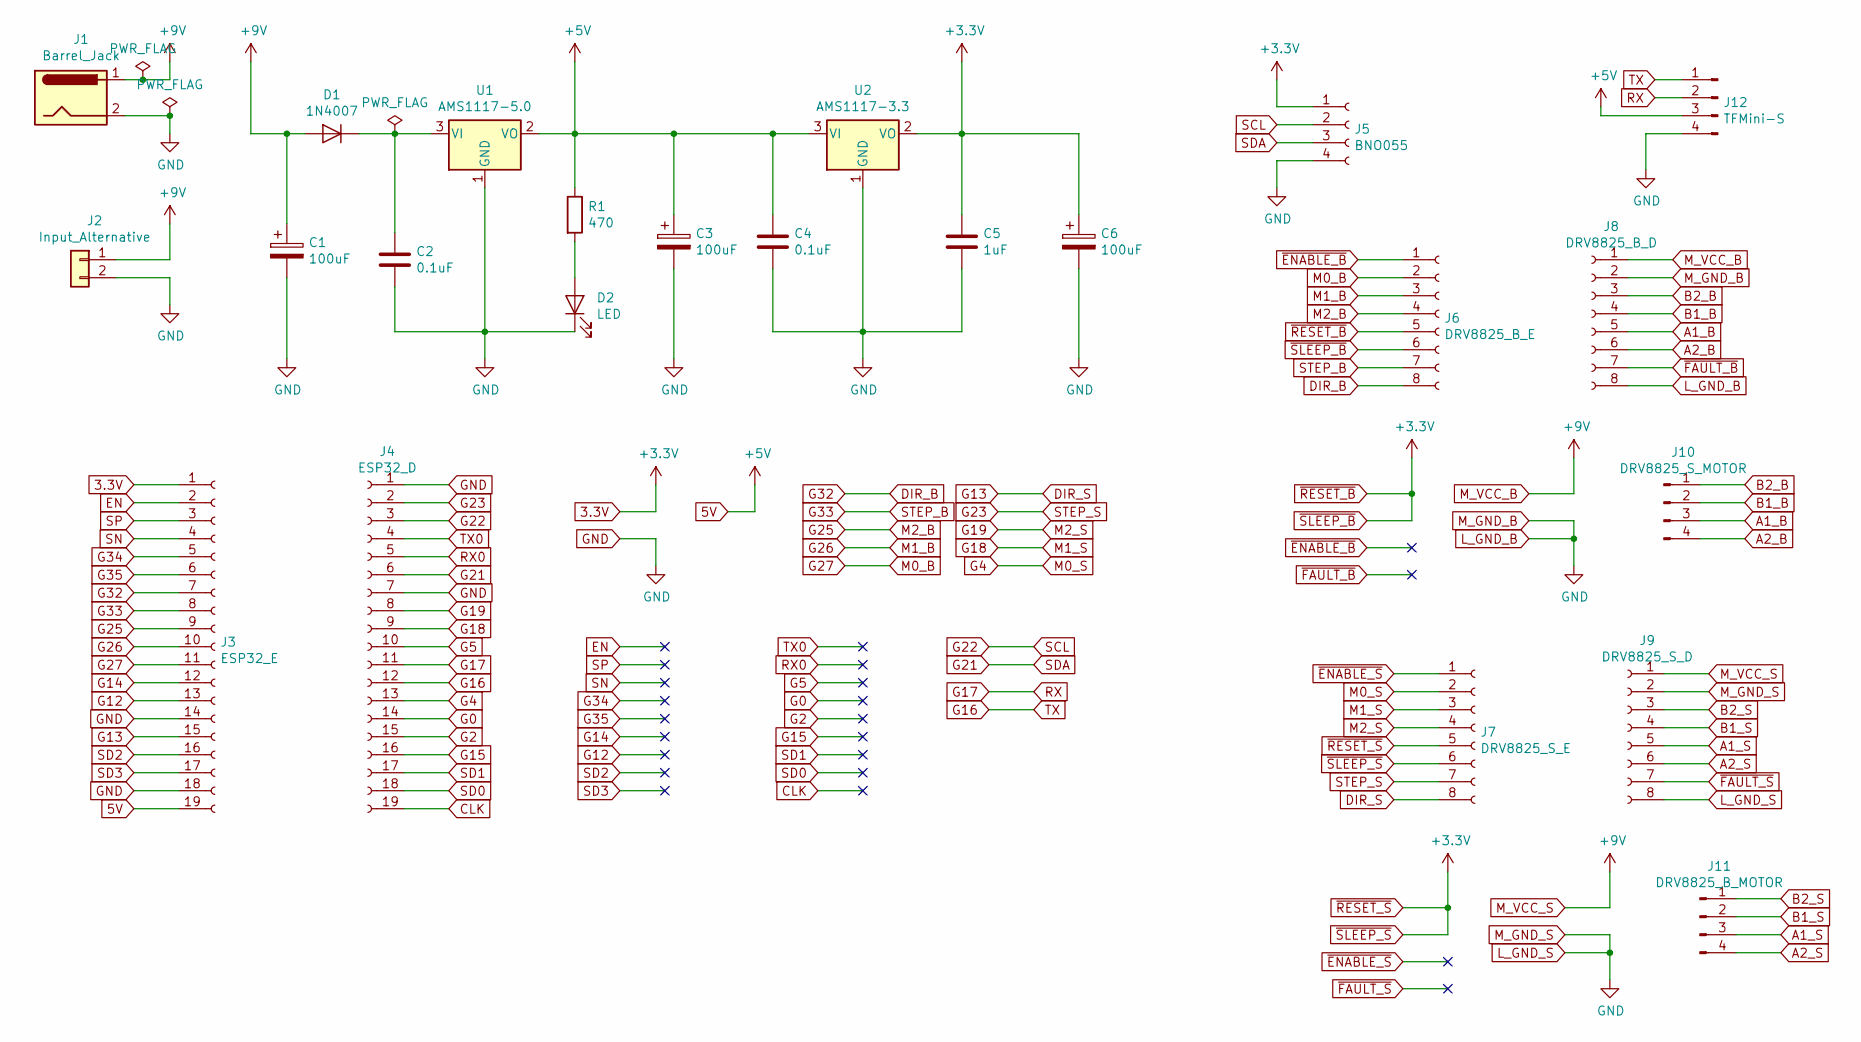
[picture p149: schematic placa_modular.sch, 3D Mapping Modular Board]

Parts:
C1, C3, C6: 100uF; CP_Radial_D10.0mm_P5.00mm
C2, C4: 0.1uF; C_Disc_D8.0mm_W2.5mm_P5.00mm
C5: 1uF; C_Disc_D7.5mm_W5.0mm_P10.00mm
D1: 1N4007; D_DO-41_SOD81_P10.16mm_Horizontal
D2: LED; LED_D5.0mm
J1: Barrel_Jack; BarrelJack_Horizontal
J2: Input_Alternative; TerminalBlock_Philmore_TB132_1x02_P5.00mm_Horizontal
J3: ESP32_E; PinSocket_1x19_P2.54mm_Vertical
J4: ESP32_D; PinSocket_1x19_P2.54mm_Vertical
J5: BNO055; PinSocket_1x04_P2.54mm_Vertical
J6: DRV8825_B_E; PinSocket_1x08_P2.54mm_Vertical
J7: DRV8825_S_E; PinSocket_1x08_P2.54mm_Vertical
J8: DRV8825_B_D; PinSocket_1x08_P2.54mm_Vertical
J9: DRV8825_S_D; PinSocket_1x08_P2.54mm_Vertical
J10: DRV8825_S_MOTOR; PinHeader_1x04_P2.54mm_Vertical
J11: DRV8825_B_MOTOR; PinHeader_1x04_P2.54mm_Vertical
J12: TFMini-S; PinSocket_1x04_P2.54mm_Vertical
R1: 470; R_Axial_DIN0207_L6.3mm_D2.5mm_P10.16mm_Horizontal
U1: AMS1117-5.0; SOT-223-3_TabPin2
U2: AMS1117-3.3; SOT-223-3_TabPin2

Connections:
3.3V: C5.1, C6.1, J3.1, J5.1, J6.5, J6.6, J7.5, J7.6, U2.2 (VO)
5V: C3.1, C4.1, J3.19, J12.3, R1.1, U1.2 (VO), U2.3 (VI)
A1_B: J8.5, J10.3
A1_S: J9.5, J11.3
A2_B: J8.6, J10.4
A2_S: J9.6, J11.4
B1_B: J8.4, J10.2
B1_S: J9.4, J11.2
B2_B: J8.3, J10.1
B2_S: J9.3, J11.1
CLK: J4.19
DIR_B: J3.7, J6.8
DIR_S: J3.15, J7.8
EN: J3.2
G0: J4.14
G2: J4.15
G4: J4.13, J7.2
G5: J4.10
G12: J3.13
G14: J3.12
G15: J4.16
G16: J4.12, J12.1
G17: J4.11, J12.2
G18: J4.9, J7.3
G19: J4.8, J7.4
G21: J4.6, J5.3
G22: J4.3, J5.2
G23: J4.2, J7.7
G25: J3.9, J6.4
G26: J3.10, J6.3
G27: J3.11, J6.2
G33: J3.8, J6.7
G34: J3.5
G35: J3.6
GND: C1.2, C2.2, C3.2, C4.2, C5.2, C6.2, D2.1 (K), J1.2, J2.2, J3.14, J3.18, J4.1, J4.7, J5.4, J8.2, J8.8, J9.2, J9.8, J12.4, U1.1 (GND), U2.1 (GND)
M_VCC_B: C1.1, D1.2 (A), J1.1, J2.1, J8.1, J9.1
unnamed: C2.1, D1.1 (K), U1.3 (VI)
unnamed: D2.2 (A), R1.2
RX0: J4.5
SD0: J4.18
SD1: J4.17
SD2: J3.16
SD3: J3.17
SN: J3.4
SP: J3.3
TX0: J4.4
~ENABLE_B: J6.1
~ENABLE_S: J7.1
~FAULT_B: J8.7
~FAULT_S: J9.7

Board: 2 copper layers, 23 parts (0 on the bottom side), 28 nets, no tracks yet.
