CarlosVieira99/3D-Indoor-Mapping/PCB and Base Design/placa_modular/placa_modular.kicad_pcb

## KiCad design PCB and Base Design/placa_modular/placa_modular.kicad_pcb (2021-06-29)

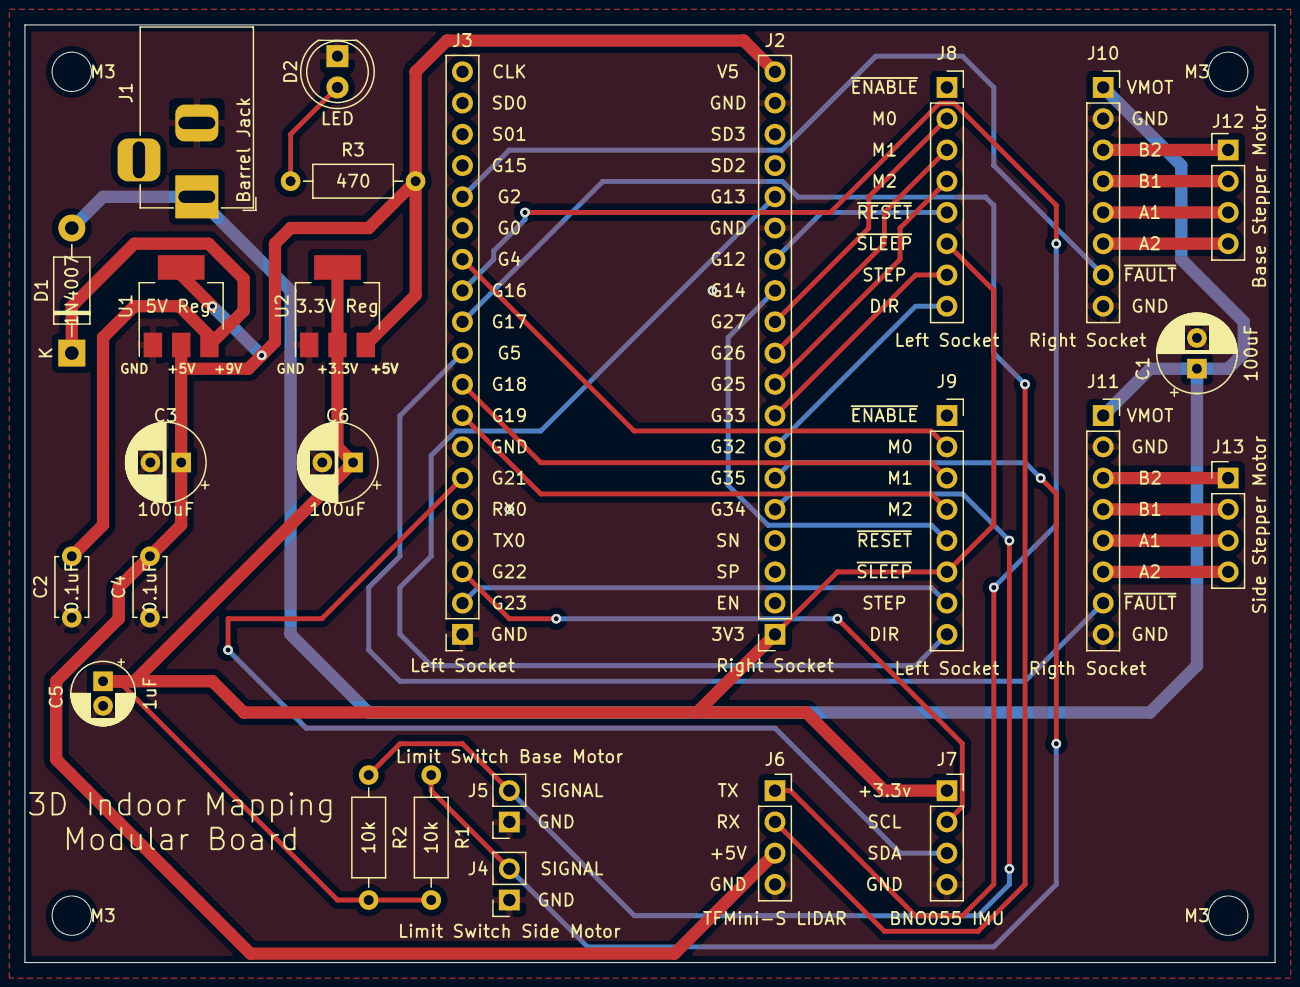
[picture p150: board PCB and Base Design/placa_modular/placa_modular.kicad_pcb from above]

Board: 2 copper layers, 101.6 x 76.2 mm, 26 parts (0 on the bottom side), 34 nets.

Parts:
C1, C3, C6: 100uF; CP_Radial_D6.3mm_P2.50mm
C2, C4: 0.1uF; C_Disc_D4.7mm_W2.5mm_P5.00mm
C5: 1uF; CP_Radial_D5.0mm_P2.00mm
D1: 1N4007; D_DO-41_SOD81_P10.16mm_Horizontal
D2: LED; LED_D5.0mm
J1: Barrel Jack; BarrelJack_Horizontal
J2: Right Socket; PinSocket_1x19_P2.54mm_Vertical
J3: Left Socket; PinSocket_1x19_P2.54mm_Vertical
J4: Limit Switch Side Motor; PinSocket_1x02_P2.54mm_Vertical
J5: Limit Switch Base Motor; PinSocket_1x02_P2.54mm_Vertical
J6: TFMini-S LIDAR; PinSocket_1x04_P2.54mm_Vertical
J7: BNO055 IMU; PinSocket_1x04_P2.54mm_Vertical
J8, J9: Left Socket; PinSocket_1x08_P2.54mm_Vertical
J10: Right Socket; PinSocket_1x08_P2.54mm_Vertical
J11: Rigth Socket; PinSocket_1x08_P2.54mm_Vertical
J12: Base Stepper Motor; PinHeader_1x04_P2.54mm_Vertical
J13: Side Stepper Motor; PinHeader_1x04_P2.54mm_Vertical
R1, R2: 10k; R_Axial_DIN0207_L6.3mm_D2.5mm_P10.16mm_Horizontal
R3: 470; R_Axial_DIN0207_L6.3mm_D2.5mm_P10.16mm_Horizontal
U1: 5V Reg.; SOT-223-3_TabPin2
U2: 3.3V Reg; SOT-223-3_TabPin2

Connections:
3.3V: C5.1, C6.1, J2.1, J7.1, J8.6, J9.6, R1.1, R2.1, U2.2
5V: C3.1, C4.1, J2.19, J6.3, R3.1, U1.2, U2.3
A1_B: J10.5, J12.3
A1_S: J11.5, J13.3
A2_B: J10.6, J12.4
A2_S: J11.6, J13.4
B1_B: J10.4, J12.2
B1_S: J11.4, J13.2
B2_B: J10.3, J12.1
B2_S: J11.3, J13.1
DIR_B: J2.7, J8.8
DIR_S: J2.15, J9.8
G2: J3.15, J10.7
G4: J3.13, J9.2
G5: J3.10, J11.7
G12: J2.13, J8.5
G14: J2.12, J9.5
G16: J3.12, J6.1
G17: J3.11, J6.2
G18: J3.9, J9.3
G19: J3.8, J9.4
G21: J3.6, J7.3
G22: J3.3, J7.2
G23: J3.2, J9.7
G25: J2.9, J8.4
G26: J2.10, J8.3
G27: J2.11, J8.2
G33: J2.8, J8.7
G34: J2.5, J5.2, R2.2
G35: J2.6, J4.2, R1.2
GND: C1.2, C2.2, C3.2, C4.2, C5.2, C6.2, D2.1, J1.2, J2.14, J2.18, J3.1, J3.7, J4.1, J5.1, J6.4, J7.4, J10.2, J10.8, J11.2, J11.8, U1.1, U2.1
M_VCC_B: C1.1, D1.2, J1.1, J10.1, J11.1
unnamed: C2.1, D1.1, U1.3
unnamed: D2.2, R3.2
