CarlosVieira99/3D-Indoor-Mapping/User Interface/SceneViewer.py

"""
Module: SceneViewer.py
@author: Carlos Vinhais
cvinhais@gmail.com
"""

import sys
import vtk
import random

from PyQt5 import QtGui, QtWidgets # QtCore,
from PyQt5.QtWidgets import QApplication
from vtk.qt.QVTKRenderWindowInteractor import QVTKRenderWindowInteractor

#  cvCOLORMAP_JET
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

class SceneViewer( QtWidgets.QWidget ):
    
    def __init__(self, parent=None):

        # Widget
        super(SceneViewer, self).__init__()

        # QtWidgets.QWidget.__init__(self, parent)
        # QtGui.QFrame.__init__(self, parent) 
        # QtGui.QGroupBox.__init__(self, parent) 

        # Main Window
        # -------------------------------------
        self.setObjectName("SceneViewer")
        self.setWindowTitle("Scene Viewer")
        self.setWindowIcon( QtGui.QIcon('icon.png') )
        # self.resize(512,512)
        
        # Setup VTK environment
        self.iren = QVTKRenderWindowInteractor(self) # can be re parented
        # self.iren.setFixedWidth( fixedWidth )
        # self.iren.setFixedHeight( fixedHeight )
        
        self.CreateVTKRenderer()
        self.CreateAxes()
        self.CreateUnitSphere()
        self.CreateXYPlane()
        self.Initialize()
        
        # Q Controls
        self._CreateVTKViewerGroup( "Scene Viewer" ) 
        self._CreateVTKModelGroup( "Model Data" )
        self._CreateVTKButtonGroup( "Actions" )

        # Q Layout
        layout = QtWidgets.QGridLayout()        
        layout.addWidget( self.iren,           0, 0, 1, 3 )
        layout.addWidget( self.vtkViewerGroup, 1, 0, 1, 1 )
        layout.addWidget( self.vtkModelGroup,  1, 1, 1, 1 )
        layout.addWidget( self.vtkButtonGroup, 1, 2, 1, 1 )        
        self.setLayout( layout )


    def CreateVTKRenderer(self):        
        # renderer
        self.ren = vtk.vtkRenderer()
        self.ren.GetActiveCamera().SetPosition(0, -30000, 10000)
        self.ren.SetBackground(0.25, 0.25, 0.25)
#        self.ren.SetBackground(0.2, 0.2, 0.2)
#        self.ren.SetBackground(1.0,1.0,1.0)
#        self.ren.SetBackground(0.0,0.0,0.0)
        
        # renderer window
        self.renWin = self.iren.GetRenderWindow()
        self.renWin.AddRenderer( self.ren )
        #self.iren.SetInteractorStyle( vtk.vtkInteractorStyleTrackballCamera() )
        self.renWin.SetInteractor( self.iren )

        self.cornerAnnotation = vtk.vtkCornerAnnotation()
        self.cornerAnnotation.SetLinearFontScaleFactor(2)
        self.cornerAnnotation.SetNonlinearFontScaleFactor(1)
        self.cornerAnnotation.SetMaximumFontSize(15)
        self.cornerAnnotation.GetTextProperty().SetColor(1, 1, 1)
        self.cornerAnnotation.SetText(0, "Instituto Superior de Engenharia do Porto" ) # m_TextAnnotation2.c_str() )
        self.cornerAnnotation.SetText(1, "Carlos Silva & Carlos A. Vinhais" ) # m_TextAnnotation3.c_str() )
        self.cornerAnnotation.SetText(2, "Total Points: 0")
        self.cornerAnnotation.SetText(3, "PPS: 0" ) # m_TextAnnotation3.c_str() )
        
        self.ren.AddViewProp( self.cornerAnnotation )  
       
    def CreateAxes(self):
        # axesActor
        #self.axesActor = vtk.vtkAxesActor()
        #self.ren.AddActor( self.axesActor )

        # OrientationMarker 
        self.markerActor = vtk.vtkAxesActor()
        self.axes = vtk.vtkOrientationMarkerWidget()
        self.axes.SetOrientationMarker( self.markerActor )
        self.axes.SetInteractor( self.iren )
        self.axes.EnabledOn()
        self.axes.InteractiveOn()

    def CreateUnitSphere(self):

        sphereSource = vtk.vtkSphereSource()
        sphereSource.SetRadius( 100 )
        sphereSource.SetThetaResolution( 36 )
        sphereSource.SetPhiResolution( 18 )
        sphereSource.Update()  
        
        self.unitSphere = vtk.vtkPolyData()
        self.unitSphere = sphereSource.GetOutput()

        mapper = vtk.vtkPolyDataMapper()
        mapper.SetInputData( self.unitSphere )

        self.unitSphereActor = vtk.vtkActor()
        self.unitSphereActor.SetMapper( mapper )

        self.unitSphereActor.GetProperty().SetColor( 1, 0, 0 ) # (R,G,B)
        self.unitSphereActor.GetProperty().SetOpacity( 0.5 )
        self.ren.AddActor( self.unitSphereActor )
    #    actor.GetProperty().EdgeVisibilityOn() 
    #    actor.GetProperty().SetEdgeColor( 0.75, 0.75, 0.75)
    #    actor.SetTexture( texture )

    
    def CreateXYPlane(self):
        planeSource = vtk.vtkPlaneSource()
        #planeSource.SetNumberOfSides(50)
        #planeSource.SetRadius(12000)
        #planeSource.SetCenter(0, 0, 0)
        planeSource.SetXResolution( 24 )
        planeSource.SetYResolution( 24 )
        planeSource.SetOrigin( -12000, -12000, 0 )
        planeSource.SetPoint1(  12000, -12000, 0 )
        planeSource.SetPoint2( -12000,  12000, 0 )
        planeSource.Update()    
        plane = vtk.vtkPolyData()
        plane = planeSource.GetOutput()
        mapper = vtk.vtkPolyDataMapper()
        mapper.SetInputData( plane )
        self.planeActor = vtk.vtkActor()
        self.planeActor.SetMapper( mapper )
        self.planeActor.GetProperty().EdgeVisibilityOn() 
        self.planeActor.GetProperty().SetEdgeColor( 1, 1, 1)
        self.planeActor.GetProperty().SetOpacity( 0.5 )
        self.ren.AddActor( self.planeActor )

    def DisplaySphere(self, center, radius):
        sphereSource = vtk.vtkSphereSource()
        sphereSource.SetCenter( center )
        sphereSource.SetRadius( radius )
        sphereSource.SetThetaResolution( 36 )
        sphereSource.SetPhiResolution( 18 )
        sphere = vtk.vtkPolyData()
        sphere = sphereSource.GetOutput()
        sphere.Update()
        mapper = vtk.vtkPolyDataMapper()
        mapper.SetInputData( sphere )
        actor = vtk.vtkActor()
        actor.GetProperty().SetColor( 1,1,1 ) # (R,G,B)
        #actor.GetProperty().EdgeVisibilityOn() 
        #actor.GetProperty().SetEdgeColor( 0.75, 0.75, 0.75)
        actor.GetProperty().SetOpacity( 0.5 )
        #actor.SetTexture( texture )
        actor.SetMapper( mapper )
        self.ren.AddActor( actor )
    
    def Initialize(self):
        self.ren.ResetCamera()
        self.renWin.Render()
        self.iren.Initialize()
        self.iren.Start()   

    # ===========================================================
    # OBJECTS
    # ===========================================================    
        
    def DisplayPolyData(self, polydata, opacity, withedges ):
        mapper = vtk.vtkPolyDataMapper()
        mapper.SetInputData( polydata )
        actor = vtk.vtkActor()
        #actor.GetProperty().SetColor( randomColor() ) # ( 0.5, 0.5, 0.5 )
        #actor.GetProperty().SetColor( 0.75, 0.75, 0.75 )
        actor.GetProperty().SetOpacity( opacity )
        #actor.GetProperty().BackfaceCullingOn()
        actor.SetMapper( mapper )
        if ( withedges == 1 ):
#            actor.GetProperty().SetEdgeColor(1.0, 1.0, 1.0)
            actor.GetProperty().SetEdgeColor(1.0, 0.0, 0.0) # RED
#            actor.GetProperty().SetEdgeColor(0.0, 0.0, 0.0)
            actor.GetProperty().EdgeVisibilityOn()    
        self.ren.AddActor( actor )

    def GlyphPoints(self, shape, radius ):
        sphere = vtk.vtkSphereSource()
        sphere.SetRadius( radius )
        glyph = vtk.vtkGlyph3D()
        glyph.SetInputData( shape )
        glyph.SetSourceConnection( sphere.GetOutputPort() )
        glyph.GeneratePointIdsOn()
        glyph.Update()   
        mapper = vtk.vtkPolyDataMapper()
        mapper.SetInputData( glyph.GetOutput() )
        actor = vtk.vtkActor()
        actor.GetProperty().SetColor( randomColor() ) # (R,G,B)
        actor.SetMapper( mapper )
        self.ren.AddActor( actor )

    def LabelPoints(self, shape ):
        mapper = vtk.vtkLabeledDataMapper()
        mapper.SetInputData( shape )

#        mapper.SetLabelModeToLabelIds()
        # or
        mapper.SetFieldDataName( "labels" )
        mapper.SetLabelModeToLabelFieldData()
        #mapper.SetFieldDataArray( 2 )

        actor = vtk.vtkActor2D()
        actor.GetProperty().SetColor( randomColor() ) # (R,G,B)
        actor.SetMapper( mapper )
        self.ren.AddActor( actor )


    def DisplayCenterline(self, centerline, radius, scale, flag ):
        self.GlyphPoints( centerline, radius )
        self.GlyphFrenet( centerline, scale )
        if ( flag ):
            self.LabelPoints( centerline )
        
    def GlyphFrenet(self, centerline, scale ):
        centerline.GetPointData().SetActiveVectors( "FSNormals")
        self.GlyphVectors( centerline, scale, [1,0,0] ) # X = RED
        centerline.GetPointData().SetActiveVectors( "FSBinormals" )
        self.GlyphVectors( centerline, scale, [0,1,0] ) # Y = GREEN
        centerline.GetPointData().SetActiveVectors( "FSTangents" )
        self.GlyphVectors( centerline, scale, [0,0,1] ) # Z = BLUE 
    
    def GlyphVectors(self, polydata, scale, color ):
        arrow = vtk.vtkArrowSource()
        glyph = vtk.vtkGlyph3D()
        glyph.SetSourceConnection( arrow.GetOutputPort() )
        glyph.SetInput( polydata ) 
        glyph.SetVectorModeToUseVector()
        glyph.SetScaleModeToScaleByVector()
        glyph.SetScaleFactor( scale ) # 
        glyph.OrientOn()
        glyph.Update()
        gPolyData = vtk.vtkPolyData()
        gPolyData.DeepCopy( glyph.GetOutput() )
        mapper = vtk.vtkPolyDataMapper()
        mapper.SetInputData( gPolyData )
        mapper.SetScalarModeToUsePointFieldData()
        actor = vtk.vtkActor()
        actor.SetMapper( mapper )
        actor.GetProperty().SetColor( color ) # (R,G,B)
        self.ren.AddActor( actor )
            
    def GlyphNormals(self, polydata, scale ):
        # Source for the glyph filter
        arrow = vtk.vtkArrowSource()
        arrow.Update() 
        #arrow.SetTipResolution( 16 )
        #arrow.SetTipLength( 0.3 )
        #arrow.SetTipRadius( 0.1 )
        ## Choose a random subset of polydata points.
        #maskPts = vtk.vtkMaskPoints()
        #maskPts.SetOnRatio( 5 )
        #maskPts.SetInput( polydata )
        #maskPts.Update()    
        #glyph.SetInput( maskPts.GetOutput() )
        glyph = vtk.vtkGlyph3D()
        glyph.SetSourceConnection( arrow.GetOutputPort() )
        glyph.SetInput( polydata )
        #glyph.SetInput( maskPts.GetOutput() )
        glyph.SetVectorModeToUseNormal()
        glyph.SetScaleModeToScaleByVector()
        glyph.SetScaleFactor( scale )
        glyph.SetColorModeToColorByVector()
        glyph.OrientOn()
        glyph.Update()
        mapper = vtk.vtkPolyDataMapper()
        mapper.SetInputConnection( glyph.GetOutputPort() )
        mapper.SetScalarModeToUsePointFieldData()
    #    mapper.SetColorModeToMapScalars()
    #    mapper.ScalarVisibilityOn()
        actor = vtk.vtkActor()
        actor.SetMapper( mapper )
        actor.GetProperty().SetColor( [1,0,0] ) # (R,G,B)
        self.ren.AddActor( actor )    

    def DisplayLineBetweenTwoPoints( self, p1, p2 ):
        points = vtk.vtkPoints()
        points.InsertNextPoint( p1 )
        points.InsertNextPoint( p2 )
        line = vtk.vtkLine()               # Create the first line (between Origin and P0)
        line.GetPointIds().SetId(0, 0)     # the second 0 is the index of the Origin in the vtkPoints
        line.GetPointIds().SetId(1, 1)     # the second 1 is the index of P0 in the vtkPoints
        lines = vtk.vtkCellArray()         # Create the topology of the point (a vertex)
        lines.InsertNextCell( line )

        path = vtk.vtkPolyData()
        path.SetPoints( points )
        path.SetLines( lines )

        mapper = vtk.vtkPolyDataMapper()
        mapper.SetInputData( path )
        
        actor = vtk.vtkActor()
        actor.GetProperty().SetEdgeColor( 1.0, 1.0, 1.0 )
        actor.GetProperty().EdgeVisibilityOn()   
        actor.SetMapper( mapper )
        self.ren.AddActor( actor )
        

    # ===========================================================
    # Q Control Groups
    # ===========================================================  
        
    def _CreateVTKViewerGroup(self, title ):
        self.vtkViewerGroup = QtWidgets.QGroupBox( title )
        self.vtkViewerGroup.setStyleSheet("QGroupBox { font-weight: bold; } ")
        
        # Check Box
        self.checkBox0 = QtWidgets.QCheckBox("World Axes")
        self.checkBox1 = QtWidgets.QCheckBox("Unit Sphere")
        self.checkBox2 = QtWidgets.QCheckBox("WXY Plane") 
        self.checkBox0.setChecked( True )
        self.checkBox1.setChecked( True )
        self.checkBox2.setChecked( True )        

        # Layout
        layout = QtWidgets.QGridLayout()        
        layout.addWidget( self.checkBox0, 0, 0 )
        layout.addWidget( self.checkBox1, 1, 0 )
        layout.addWidget( self.checkBox2, 2, 0 )
        self.vtkViewerGroup.setLayout( layout )
        
        # Callbacks
        self.checkBox0.clicked.connect( self.SetSceneVisibility )
        self.checkBox1.clicked.connect( self.SetSceneVisibility )
        self.checkBox2.clicked.connect( self.SetSceneVisibility )


    def _CreateVTKModelGroup(self, title ):
        self.vtkModelGroup = QtWidgets.QGroupBox( title )
        self.vtkModelGroup.setStyleSheet("QGroupBox { font-weight: bold; } ")

        # Check Box: mesh
        self.checkBox3 = QtWidgets.QCheckBox("centerline")        
        self.checkBox4 = QtWidgets.QCheckBox("mesh")
        self.checkBox5 = QtWidgets.QCheckBox("rings")
        self.checkBox3.setChecked( True )
        self.checkBox4.setChecked( True )
        self.checkBox5.setChecked( True ) 
        
        # check boxes: cell data
#        self.checkBox6 = QtWidgets.QCheckBox("area")        
#        self.checkBox7 = QtWidgets.QCheckBox("frame")
#        self.checkBox8 = QtWidgets.QCheckBox("radii")
        
        # Layout
        layout = QtWidgets.QGridLayout()        
        layout.addWidget( self.checkBox3, 0, 0 )
        layout.addWidget( self.checkBox4, 1, 0 )
        layout.addWidget( self.checkBox5, 2, 0 )
#        layout.addWidget( self.checkBox6, 0, 1 )
#        layout.addWidget( self.checkBox7, 1, 1 )
#        layout.addWidget( self.checkBox8, 2, 1 )
        self.vtkModelGroup.setLayout( layout )
        

    def _CreateVTKButtonGroup(self, title ):
        self.vtkButtonGroup = QtWidgets.QGroupBox( title )
        self.vtkButtonGroup.setStyleSheet("QGroupBox { font-weight: bold; } ")
        
        # UI Buttons
        self.button_Reset = QtWidgets.QPushButton( "Reset Camera" )
        self.button_Clean = QtWidgets.QPushButton( "Clear Viewer" )
        self.button_Write = QtWidgets.QPushButton( "Write to PNG" )
        icon1 = 'SP_DialogHelpButton'
        icon2 = 'SP_DialogResetButton'
        icon3 = 'SP_DialogSaveButton'
        img1 = self.style().standardIcon(getattr(QtWidgets.QStyle, icon1))
        img2 = self.style().standardIcon(getattr(QtWidgets.QStyle, icon2))
        img3 = self.style().standardIcon(getattr(QtWidgets.QStyle, icon3))
        self.button_Reset.setIcon( img1 )
        self.button_Clean.setIcon( img2 )
        self.button_Write.setIcon( img3 )
        
        # Layout
        layout = QtWidgets.QGridLayout()        
        layout.addWidget( self.button_Reset, 0, 0 )
        layout.addWidget( self.button_Clean, 1, 0 )
        layout.addWidget( self.button_Write, 2, 0 )
        self.vtkButtonGroup.setLayout( layout )
        
        # Callbacks
        self.button_Reset.clicked.connect( self.ResetCamera )
#        self.button_Clean.clicked.connect( self.CleanViewer )
        self.button_Write.clicked.connect( self.WriteScreenShot )
    
    # ===========================================================
    # Q Callbacks
    # ===========================================================

    def SetSceneVisibility(self):
        self.axesActor.SetVisibility( self.checkBox0.isChecked() )
        self.unitSphereActor.SetVisibility( self.checkBox1.isChecked() )
        self.planeActor.SetVisibility( self.checkBox2.isChecked() )
        self.renWin.Render()

    def ResetCamera(self):        
        self.ren.ResetCamera()
        camera = self.ren.GetActiveCamera()
        camera.SetPosition(0, -30000, 10000)
        self.renWin.Render()

    def SetCamera(self, position, focus ):
        camera = vtk.vtkCamera()
        camera.SetPosition( position )
        camera.SetFocalPoint( focus )
        camera.SetPosition(0, -30000, 10000)
        self.ren.SetActiveCamera( camera )
        self.renWin.Render()
##        m_shape -> GetPoint( static_cast<vtkIdType>( m_selectedID ), L);
#        self.ren.GetActiveCamera().SetFocalPoint( focus )
#        self.ren.GetActiveCamera().SetPosition( position )
#        self.renWin.Render()   

    def CleanViewer(self):
        self.ren.RemoveAllViewProps()
        self.ren.AddActor( self.unitSphereActor )
        self.ren.AddActor( self.planeActor )
        self.ren.ResetCamera()
        self.renWin.Render()
        # self.iren.Render()
        
        
    # ===========================================================
    # Q Callbacks
    # ===========================================================
        
    def WriteScreenShot(self):
        outputFilename = QtWidgets.QFileDialog.getSaveFileName(
                self, 'Save Screenshot As...', 'screenshot.png',
                filter=('*.png'))[0] 
        if ( outputFilename ):
            print ( "Writing:", outputFilename )
            windowToImageFilter = vtk.vtkWindowToImageFilter()
            windowToImageFilter.SetInput( self.renWin )
            windowToImageFilter.Update()
            writer = vtk.vtkPNGWriter()
            writer.SetInputData( windowToImageFilter.GetOutput() )
            writer.SetFileName( outputFilename )
            writer.Write()

# ===============================================	
if __name__ == "__main__": 
    app = QApplication(sys.argv)
    qvtk = SceneViewer()
    # ------------------------------------------- 
    qvtk.GlyphPoints( qvtk.unitSphere, 0.01 )
    qvtk.DisplayLineBetweenTwoPoints( [0,0,0], [0,0,1] )
    qvtk.ren.ResetCamera()
    # -------------------------------------------     
    qvtk.show()
    sys.exit(app.exec_())
    # app.quit()
# ===============================================	
# EOF.
